rpineau/RTI-Dome/domelist RTI-Dome.txt

//See hardwarelist.txt for details on this file format.
//Version|Manufacturer|Model|Comment|MapsTo|PlugInDllName|X2Developer|Windows|Mac|Linux|
2|RTI-Zone|RTI-Dome|RTI-Dome Arduino DUE Controller| |libRTI-Dome|X2Dome m1OASYS|1|1|1|
