rpineau/RTI-Dome/Hardware/RTI-Dome-Shutter/RTI-Dome-Shutter.brd

## EAGLE design Hardware/RTI-Dome-Shutter/RTI-Dome-Shutter.brd (2022-07-01)

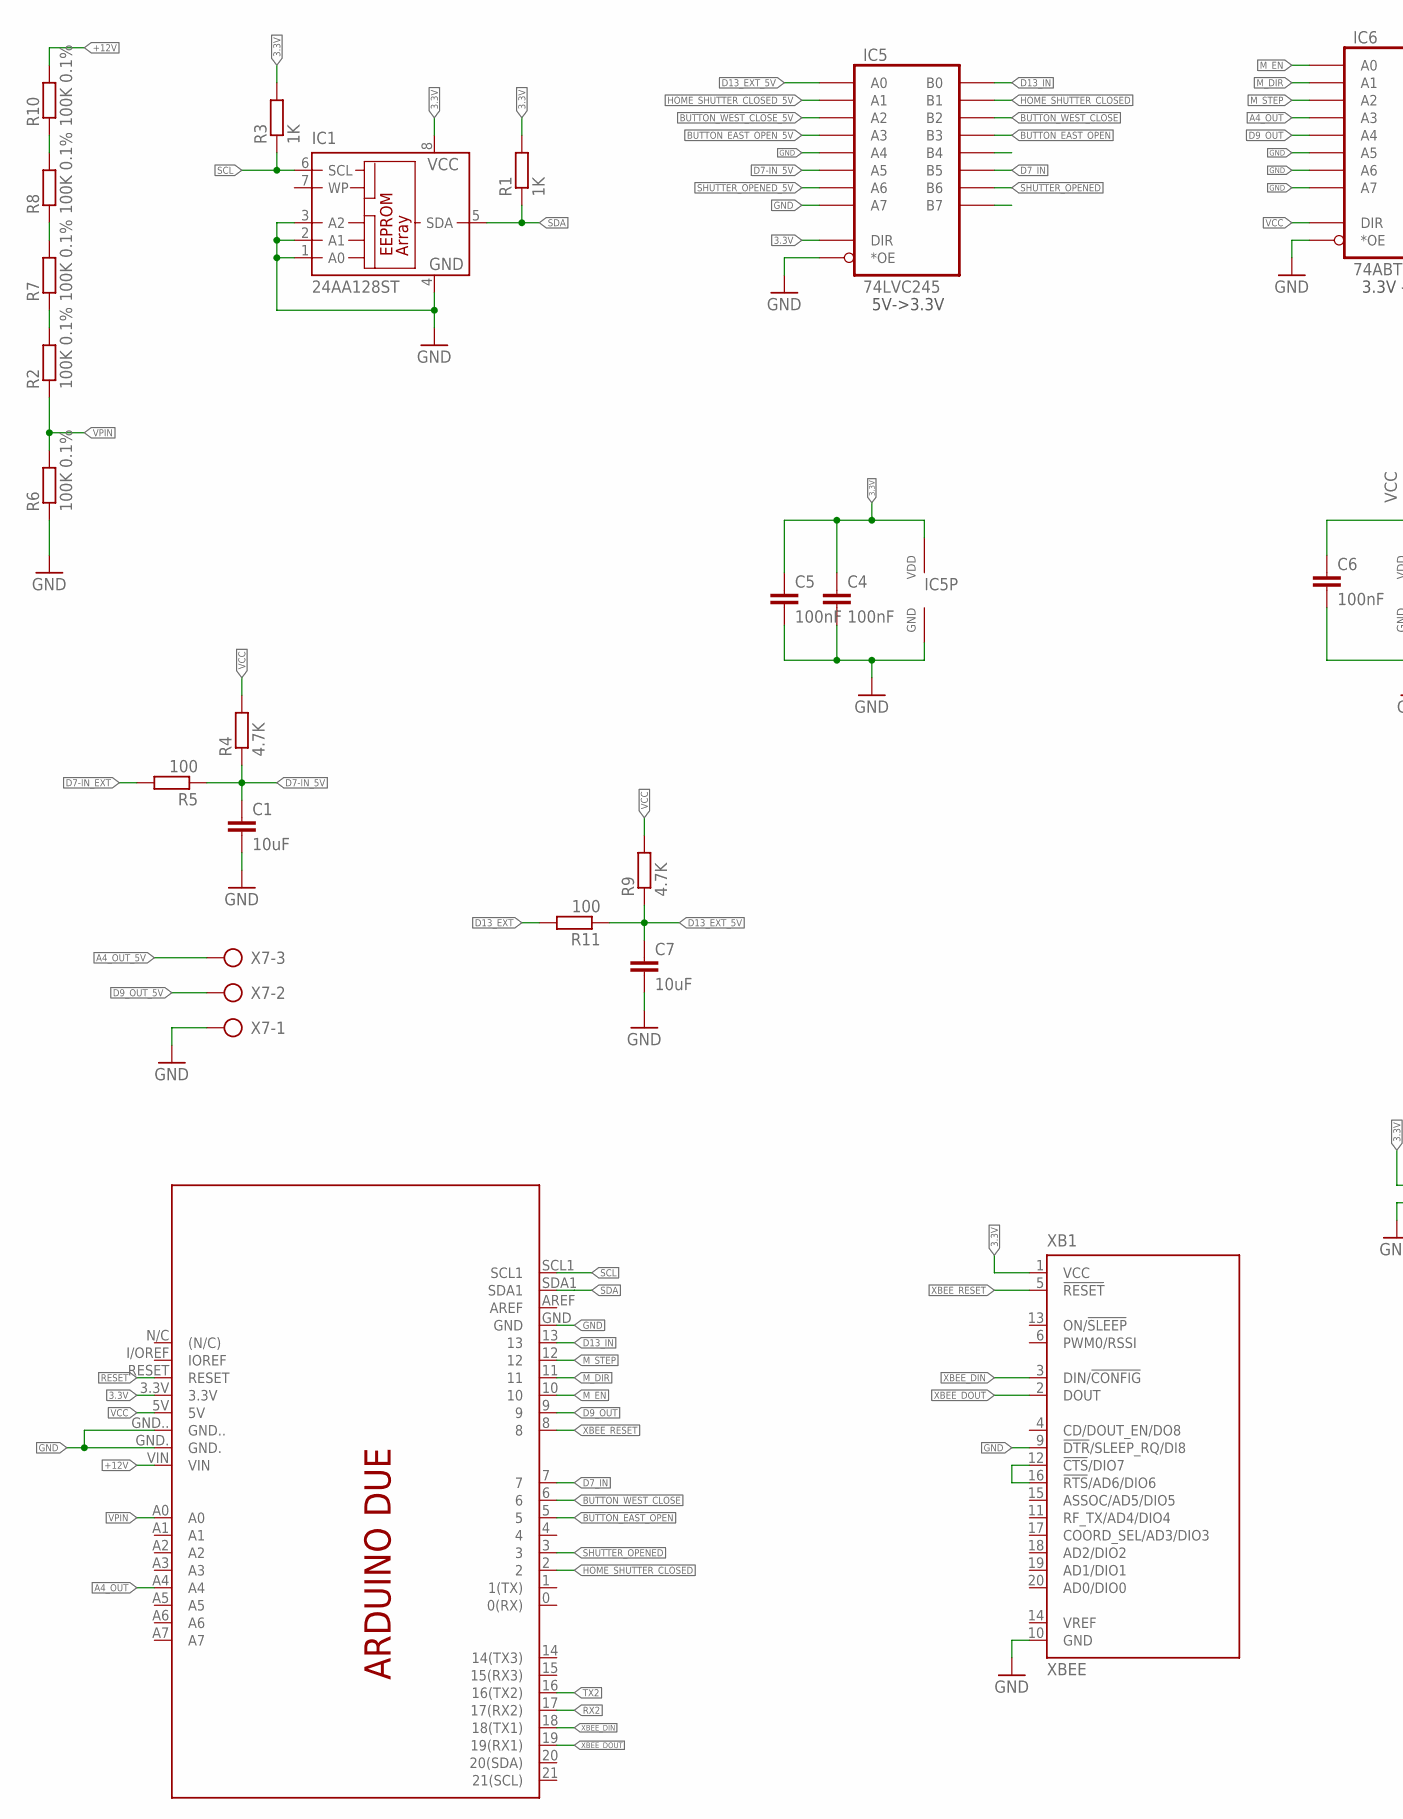
[picture p1: schematic RTI-Dome-Shutter.sch, part in row 1, column 1]

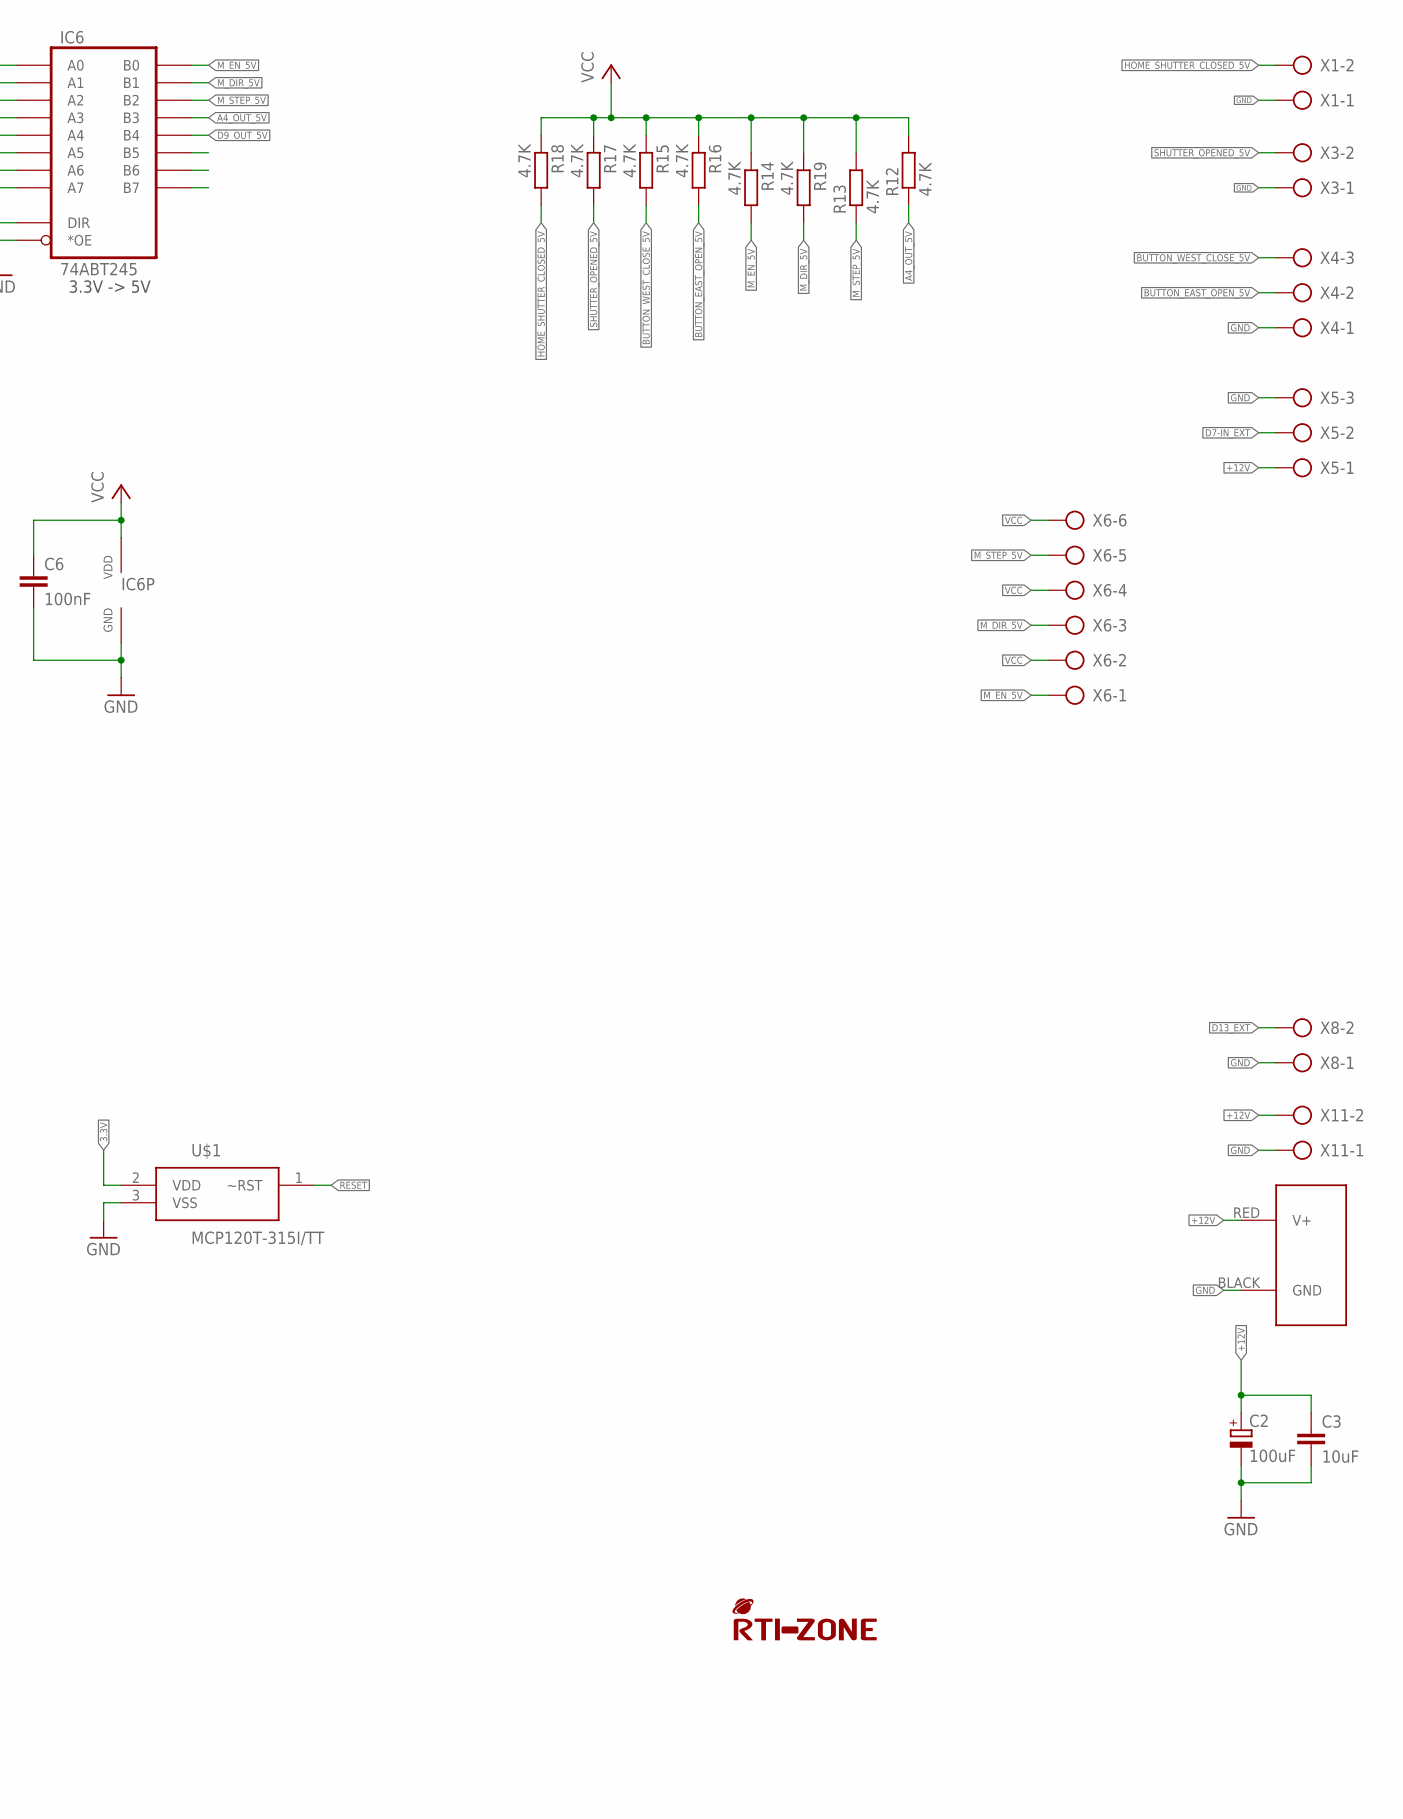
[picture p2: schematic RTI-Dome-Shutter.sch, part in row 1, column 2]

Parts:
C1, C3, C7: 10uF; C0805
C2: 100uF; UD-10X10_NICHICON
C4, C5, C6: 100nF; C0805
IC1: 24AA128ST; TSSOP8
IC5: 74LVC245; TSSOP20
IC6: 74ABT245; TSSOP20
J1: POWERPOLE_POWER45A; POWERPOLE_PAIR_45A
PCB1: ARDUINO_DUE_SHIELD_SHORT
R1, R3: 1K; R0805
R2, R6, R7, R8, R10: 100K 0.1%; R0805
R4, R9, R12, R13, R14, R15, R16, R17, R18, R19: 4.7K; R0805
R5, R11: 100; R0805
U$1: MCP120T-315I/TT; SOT95P237X112-3N; MPN MCP120T-315I/TT
U$4: RTI-LOGO_BIG; LOGO_BIG
X1, X3, X8, X11: AK500/2
X4, X5, X7: AK500/3
X6: AK500/6
XB1: XBEE

Connections:
3.3V: C4.1, C5.1, IC1.8 (VCC), IC5.P$1 (DIR), IC5.P$20 (VDD), PCB1.3.3V, R1.2, R3.2, U$1.2 (VDD), XB1.1 (VCC)
+12V: C2.+, C3.1, J1.RED (V+), PCB1.VIN, R10.2, X5.1, X11.2
A4_OUT: IC6.P$5 (A3), PCB1.A4
A4_OUT_5V: IC6.P$15 (B3), R12.1, X7.3
BUTTON_EAST_OPEN: IC5.P$15 (B3), PCB1.5
BUTTON_EAST_OPEN_5V: IC5.P$5 (A3), R16.2, X4.2
BUTTON_WEST_CLOSE: IC5.P$16 (B2), PCB1.6
BUTTON_WEST_CLOSE_5V: IC5.P$4 (A2), R15.2, X4.3
D7-IN_5V: C1.1, IC5.P$7 (A5), R4.1, R5.1
D7-IN_EXT: R5.2, X5.2
D7_IN: IC5.P$13 (B5), PCB1.7
D9_OUT: IC6.P$6 (A4), PCB1.9
D9_OUT_5V: IC6.P$14 (B4), X7.2
D13_EXT: R11.2, X8.2
D13_EXT_5V: C7.1, IC5.P$2 (A0), R9.1, R11.1
D13_IN: IC5.P$18 (B0), PCB1.13
GND: C1.2, C2.-, C3.2, C4.2, C5.2, C6.2, C7.2, IC1.1 (A0), IC1.2 (A1), IC1.3 (A2), IC1.4 (GND), IC5.P$6 (A4), IC5.P$9 (A7), IC5.P$10 (GND), IC5.P$19 (*OE), IC6.P$7 (A5), IC6.P$8 (A6), IC6.P$9 (A7), IC6.P$10 (GND), IC6.P$19 (*OE), J1.BLACK (GND), PCB1.GND, PCB1.GND., PCB1.GND.., R6.1, U$1.3 (VSS), X1.1, X3.1, X4.1, X5.3, X7.1, X8.1, X11.1, XB1.9 (!DTR!/SLEEP_RQ/DI8), XB1.10 (GND)
HOME_SHUTTER_CLOSED: IC5.P$17 (B1), PCB1.2
HOME_SHUTTER_CLOSED_5V: IC5.P$3 (A1), R18.2, X1.2
M_DIR: IC6.P$3 (A1), PCB1.11
M_DIR_5V: IC6.P$17 (B1), R19.2, X6.3
M_EN: IC6.P$2 (A0), PCB1.10
M_EN_5V: IC6.P$18 (B0), R14.2, X6.1
M_STEP: IC6.P$4 (A2), PCB1.12
M_STEP_5V: IC6.P$16 (B2), R13.1, X6.5
unnamed: R7.2, R8.1
unnamed: R8.2, R10.1
unnamed: R2.2, R7.1
unnamed: XB1.12 (!CTS!/DIO7), XB1.16 (!RTS!/AD6/DIO6)
RESET: PCB1.RESET, U$1.1 (~RST)
RX2: PCB1.17 (17(RX2))
SCL: IC1.6 (SCL), PCB1.SCL1, R3.1
SDA: IC1.5 (SDA), PCB1.SDA1, R1.1
SHUTTER_OPENED: IC5.P$12 (B6), PCB1.3
SHUTTER_OPENED_5V: IC5.P$8 (A6), R17.2, X3.2
TX2: PCB1.16 (16(TX2))
VCC: C6.1, IC6.P$1 (DIR), IC6.P$20 (VDD), PCB1.5V, R4.2, R9.2, R12.2, R13.2, R14.1, R15.1, R16.1, R17.1, R18.1, R19.1, X6.2, X6.4, X6.6
VPIN: PCB1.A0, R2.1, R6.2
XBEE_DIN: PCB1.18 (18(TX1)), XB1.3 (DIN/!CONFIG)
XBEE_DOUT: PCB1.19 (19(RX1)), XB1.2 (DOUT)
XBEE_RESET: PCB1.8, XB1.5 (!RESET)

Notes on the sheet:
5V->3.3V
3.3V -> 5V

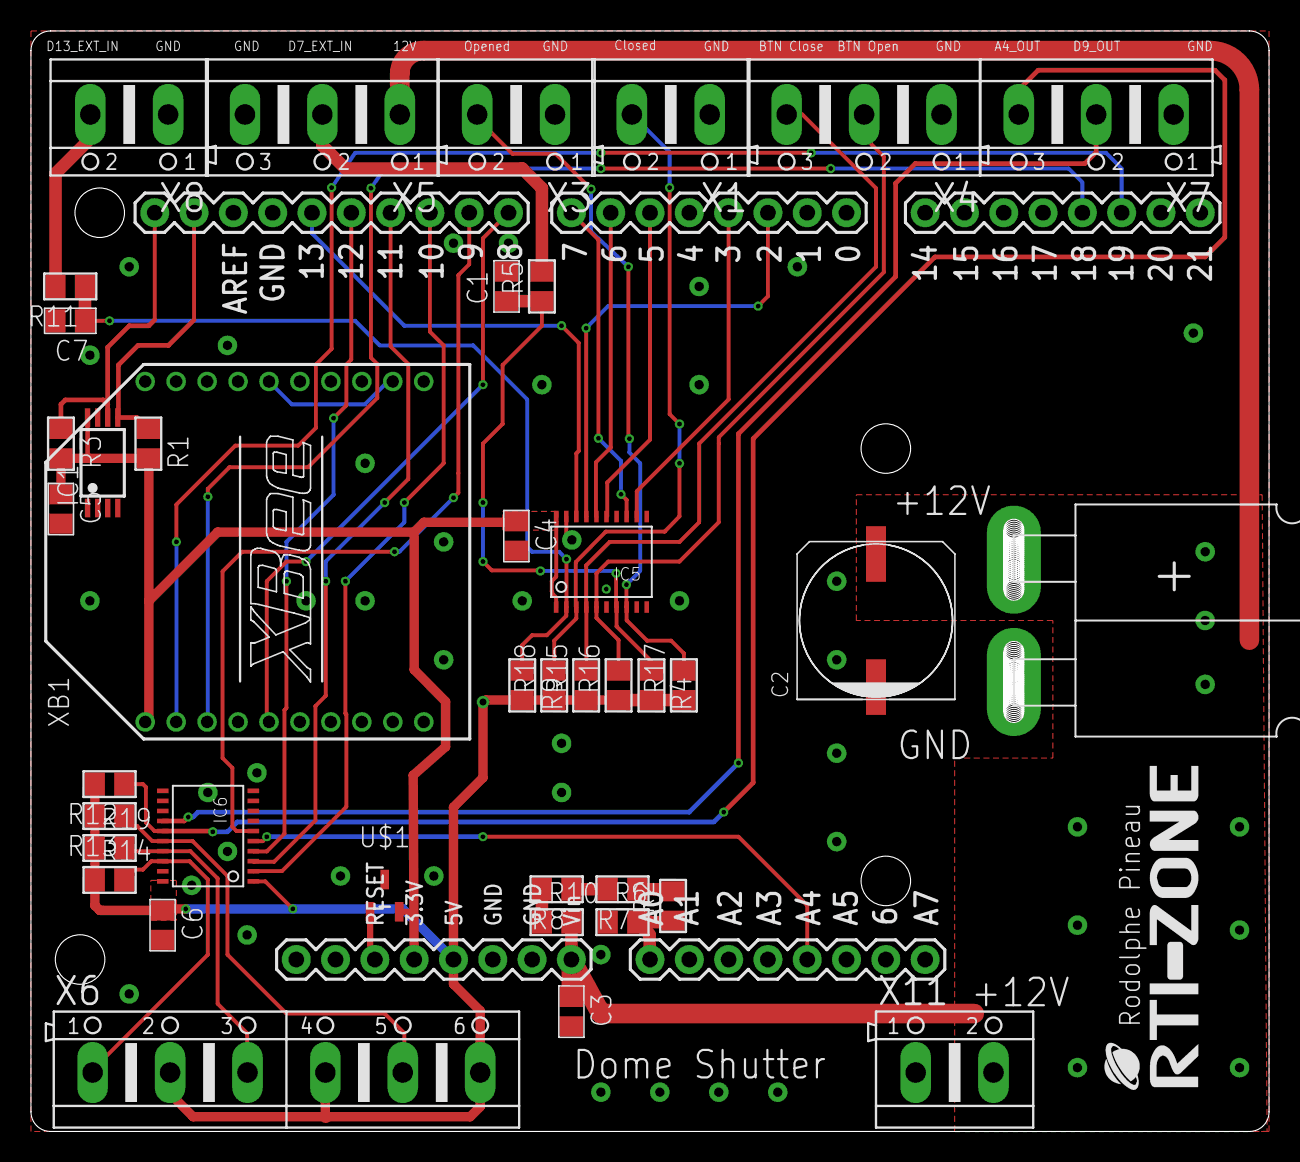
[picture p3: board RTI-Dome-Shutter.brd from above]

Board: 2 copper layers, 80.0 x 71.1 mm, 42 parts (0 on the bottom side), 39 nets.
