rpineau/RTI-Dome/Hardware/12V_switching.brd

## EAGLE design Hardware/12V_switching.brd (2021-03-28)

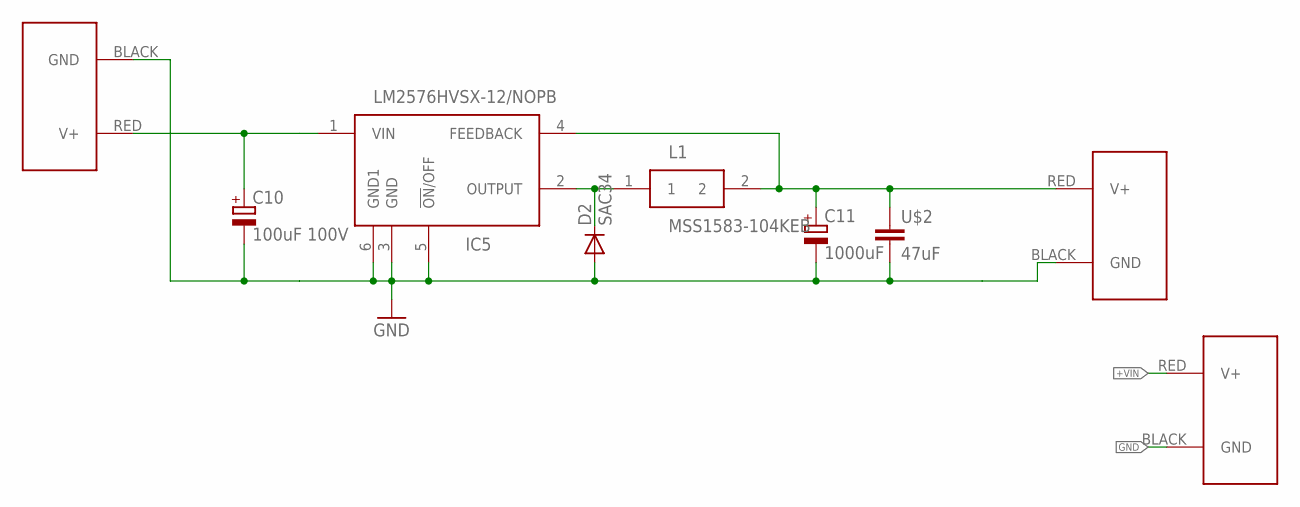
[picture p4: schematic 12V_switching.sch]

Parts:
C10: 100uF 100V; UD-10X10_NICHICON
C11: 1000uF; UD-10X10_NICHICON
D2: SAC34; DO-214AC
IC5: LM2576HVSX-12/NOPB; TO263-5; MOUSER_PART_NUMBER LM2576HVSX-12/NOPB
J1, J2, J3: POWERPOLE_POWER45A; POWERPOLE_PAIR_45A
L1: MSS1583-104KEB; INDPM150150X860N
U$2: 47uF; C1206

Connections:
12VOUT: D2.C, IC5.2 (OUTPUT), L1.1
+12V: C11.+, IC5.4 (FEEDBACK), J2.RED (V+), L1.2, U$2.1
+VIN: C10.+, IC5.1 (VIN), J1.RED (V+)
GND: C10.-, C11.-, D2.A, IC5.3 (GND), IC5.5 (!ON!/OFF), IC5.6 (GND1), J1.BLACK (GND), J2.BLACK (GND), J3.BLACK (GND), U$2.2
V+: J3.RED (V+)

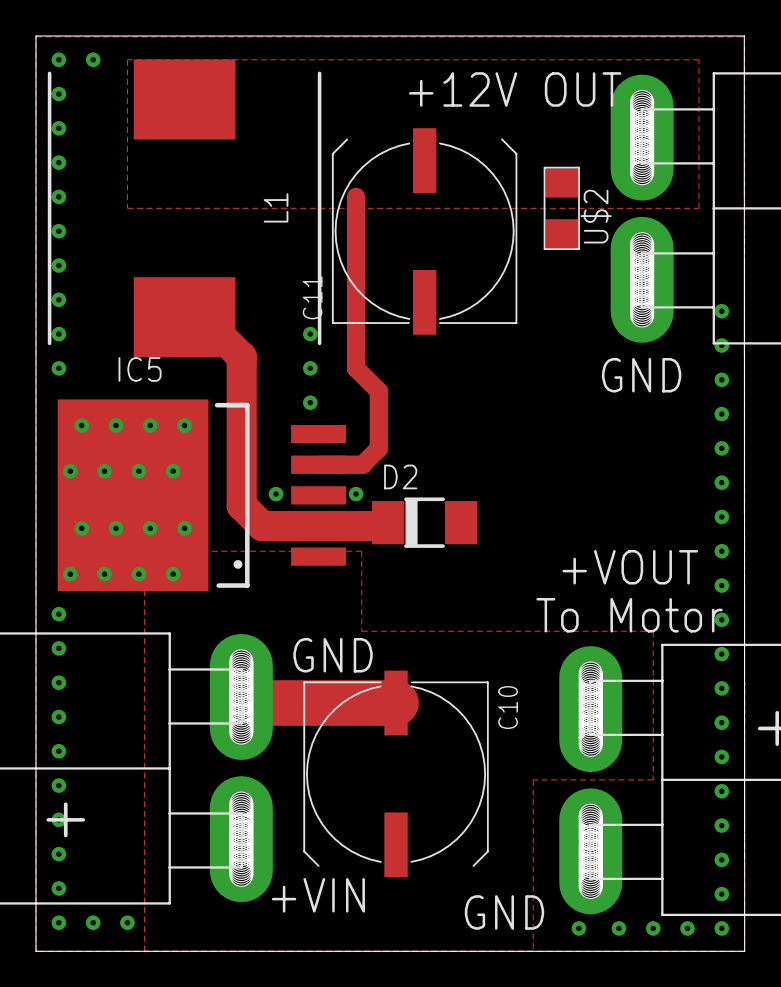
[picture p5: board 12V_switching.brd from above]

Board: 2 copper layers, 39.4 x 50.9 mm, 9 parts (0 on the bottom side), 4 nets.
