rpineau/RTI-Dome/Hardware/RTI-Dome-eth/RTI-Dome-eth.brd

## EAGLE design Hardware/RTI-Dome-eth/RTI-Dome-eth.brd (2022-07-01)

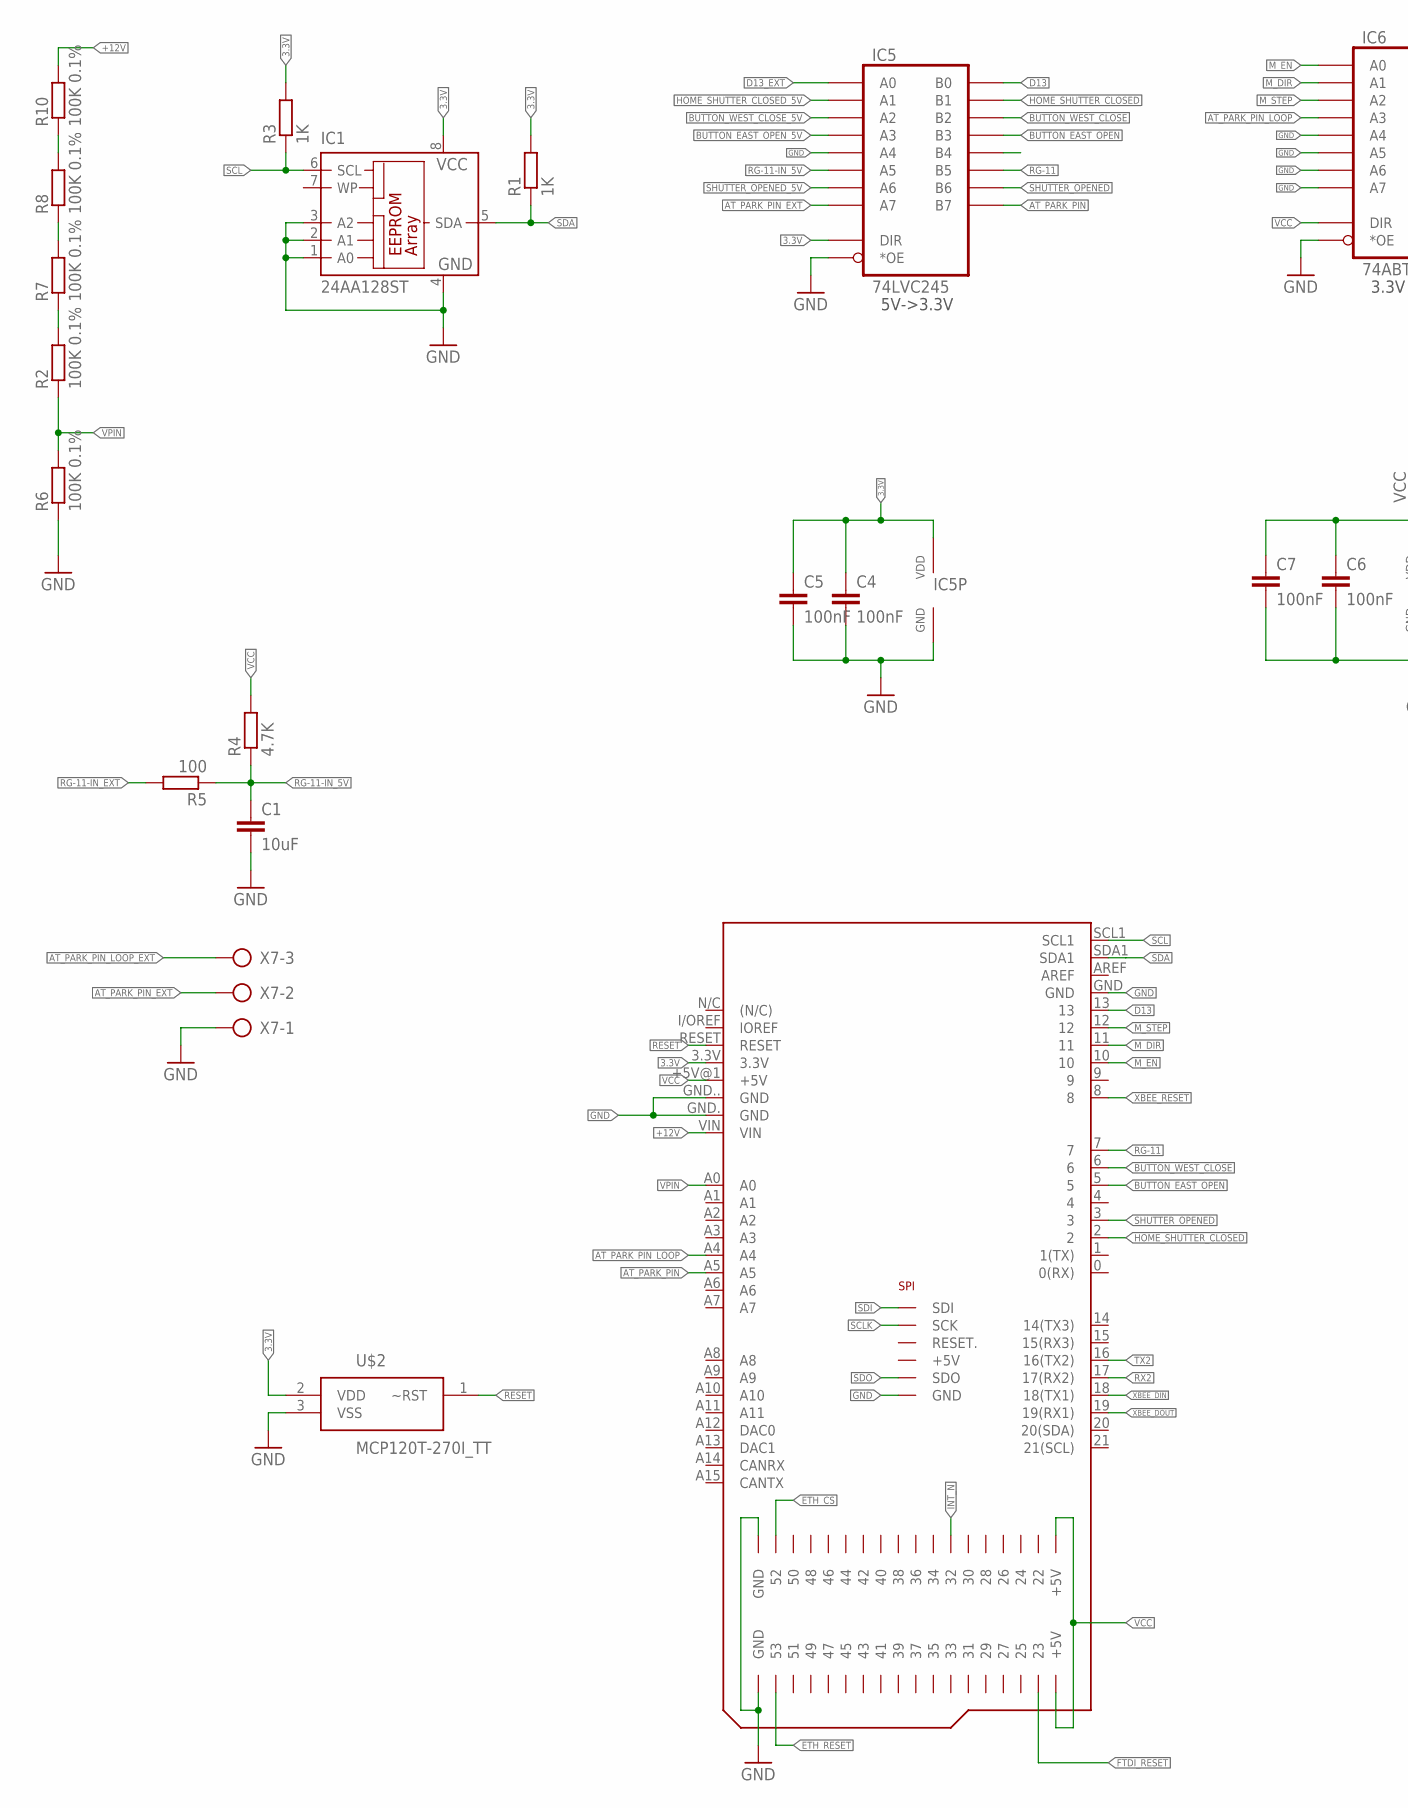
[picture p6: schematic RTI-Dome-eth.sch, sheet 1, part in row 1, column 1]

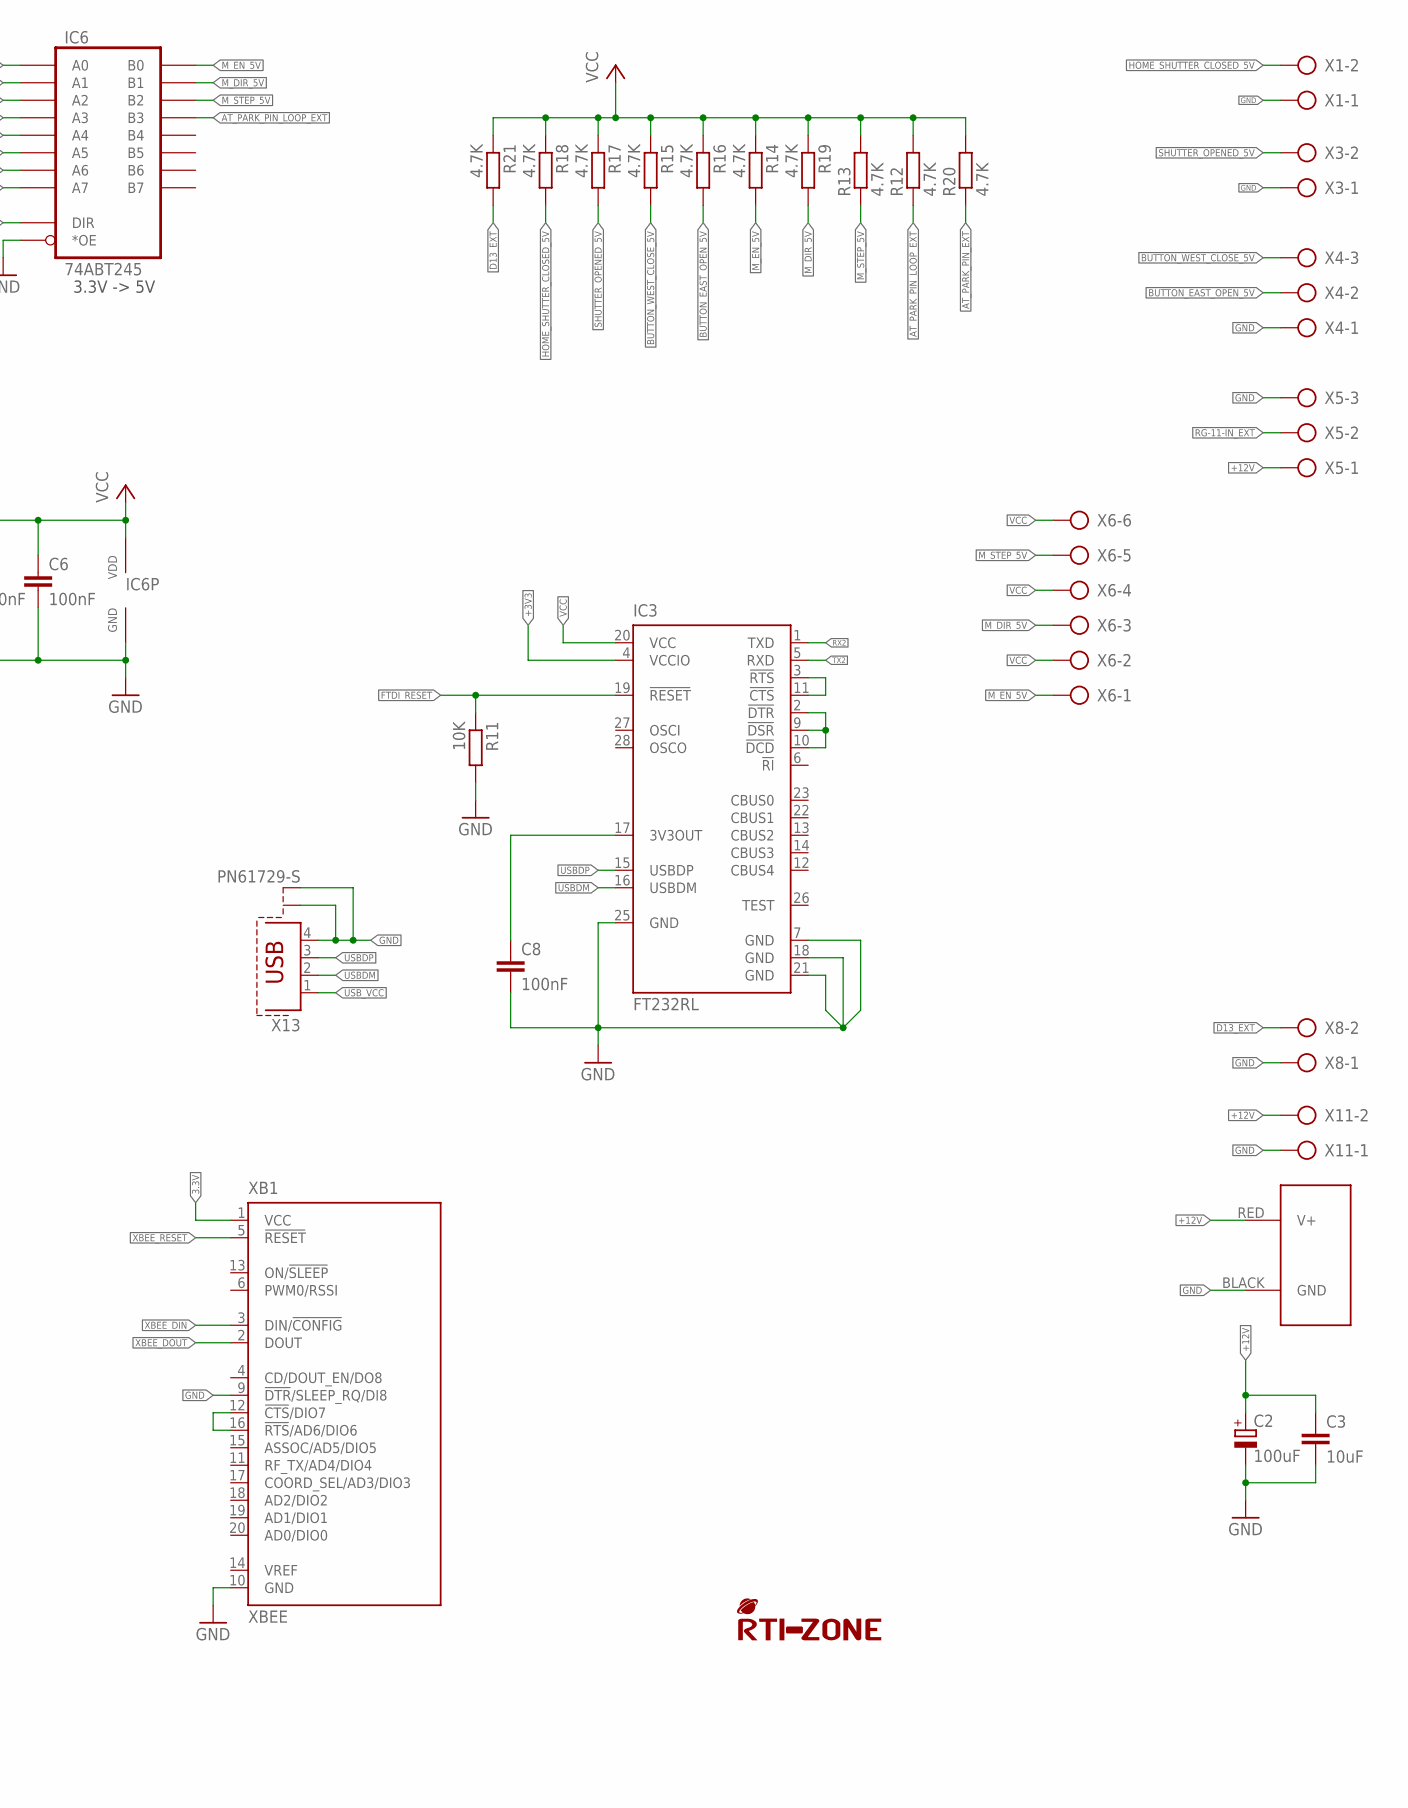
[picture p7: schematic RTI-Dome-eth.sch, sheet 1, part in row 1, column 2]

Parts:
C1, C3: 10uF; C0805; MPN CC0805KKX5R8BB106
C2: 100uF; UD-10X10_NICHICON; MPN MAL215099804E3
C4, C5, C6, C7, C8: 100nF; C0805; MPN 0805YD104KAT2A
IC1: 24AA128ST; TSSOP8
IC3: FT232RL; SSOP28; MPN FT232RL-REEL
IC5: 74LVC245; TSSOP20; MPN 74LVC245APW,112
IC6: 74ABT245; TSSOP20; MPN 74ABT245PW,112
J1: POWERPOLE_POWER45A; POWERPOLE_PAIR_45A
R1, R3: 1K; R0805; MPN RT0805FRE071KL
R2, R6, R7, R8, R10: 100K 0.1%; R0805; MPN AT0805BRD07100KL
R4, R12, R13, R14, R15, R16, R17, R18, R19, R20, R21: 4.7K; R0805; MPN RT0805FRE074K7L
R5: 100; R0805; MPN RT0805FRD07100RL
R11: 10K; R0805; MPN RT0805FRE0710KL
U$1: ARDUINO_DUE_SHIELD_FULL
U$2: MCP120T-270I_TT; SOT95P237X112-3N; MPN MCP120T-270I/TT
U$4: RTI-LOGO_BIG; LOGO_BIG
X1, X3, X8, X11: AK500/2; MPN 691101710002
X4, X5, X7: AK500/3; MPN 691101710003
X6: AK500/6; MPN 30.706
X13: PN61729-S; MPN SS-52300-001
XB1: XBEE

Connections:
3.3V: C4.1, C5.1, IC1.8 (VCC), IC5.P$1 (DIR), IC5.P$20 (VDD), R1.2, R3.2, U$1.3.3V, U$2.2 (VDD), XB1.1 (VCC)
+3V3: IC3.4 (VCCIO); also elsewhere on the board
+5V: U$1.+5V@2 (+5V)
+12V: C2.+, C3.1, J1.RED (V+), R10.2, U$1.VIN, X5.1, X11.2; also elsewhere on the board
AT_PARK_PIN: IC5.P$11 (B7), U$1.A5
AT_PARK_PIN_EXT: IC5.P$9 (A7), R20.1, X7.2
AT_PARK_PIN_LOOP: IC6.P$5 (A3), U$1.A4
AT_PARK_PIN_LOOP_EXT: IC6.P$15 (B3), R12.1, X7.3
BUTTON_EAST_OPEN: IC5.P$15 (B3), U$1.5
BUTTON_EAST_OPEN_5V: IC5.P$5 (A3), R16.2, X4.2
BUTTON_WEST_CLOSE: IC5.P$16 (B2), U$1.6
BUTTON_WEST_CLOSE_5V: IC5.P$4 (A2), R15.2, X4.3
D13: IC5.P$18 (B0), U$1.13
D13_EXT: IC5.P$2 (A0), R21.2, X8.2
DTR_DSR_DCD: IC3.2 (!DTR), IC3.9 (!DSR), IC3.10 (!DCD)
ETH_CS: U$1.52; also elsewhere on the board
ETH_RESET: U$1.53; also elsewhere on the board
FTDI_RESET: IC3.19 (!RESET), R11.1, U$1.23
GND: C1.2, C2.-, C3.2, C4.2, C5.2, C6.2, C7.2, C8.2, IC1.1 (A0), IC1.2 (A1), IC1.3 (A2), IC1.4 (GND), IC3.7 (GND), IC3.18 (GND), IC3.21 (GND), IC3.25 (GND), IC5.P$6 (A4), IC5.P$10 (GND), IC5.P$19 (*OE), IC6.P$6 (A4), IC6.P$7 (A5), IC6.P$8 (A6), IC6.P$9 (A7), IC6.P$10 (GND), IC6.P$19 (*OE), J1.BLACK (GND), R6.1, R11.2, U$1.GND, U$1.GND. (GND), U$1.GND.. (GND), U$1.GND... (GND), U$1.GND.... (GND), U$1.GND__ (GND), U$2.3 (VSS), X1.1, X3.1, X4.1, X5.3, X7.1, X8.1, X11.1, X13.4, X13.S1, X13.S2, XB1.9 (!DTR!/SLEEP_RQ/DI8), XB1.10 (GND); also elsewhere on the board
HOME_SHUTTER_CLOSED: IC5.P$17 (B1), U$1.2
HOME_SHUTTER_CLOSED_5V: IC5.P$3 (A1), R18.2, X1.2
INT_N: U$1.32; also elsewhere on the board
M_DIR: IC6.P$3 (A1), U$1.11
M_DIR_5V: IC6.P$17 (B1), R19.2, X6.3
M_EN: IC6.P$2 (A0), U$1.10
M_EN_5V: IC6.P$18 (B0), R14.2, X6.1
M_STEP: IC6.P$4 (A2), U$1.12
M_STEP_5V: IC6.P$16 (B2), R13.1, X6.5
unnamed: R7.2, R8.1
unnamed: R8.2, R10.1
unnamed: R2.2, R7.1
unnamed: C8.1, IC3.17 (3V3OUT)
unnamed: XB1.12 (!CTS!/DIO7), XB1.16 (!RTS!/AD6/DIO6)
RESET: U$1.RESET, U$2.1 (~RST)
RG-11: IC5.P$13 (B5), U$1.7
RG-11-IN_5V: C1.1, IC5.P$7 (A5), R4.1, R5.1
RG-11-IN_EXT: R5.2, X5.2
RTS_CTS: IC3.3 (!RTS), IC3.11 (!CTS)
RX2: IC3.1 (TXD), U$1.17 (17(RX2))
SCL: IC1.6 (SCL), R3.1, U$1.SCL1
SCLK: U$1.SCK; also elsewhere on the board
SDA: IC1.5 (SDA), R1.1, U$1.SDA1
SDI: U$1.MISO (SDI); also elsewhere on the board
SDO: U$1.MOSI (SDO); also elsewhere on the board
SHUTTER_OPENED: IC5.P$12 (B6), U$1.3
SHUTTER_OPENED_5V: IC5.P$8 (A6), R17.2, X3.2
TX2: IC3.5 (RXD), U$1.16 (16(TX2))
USBDM: IC3.16 (USBDM), X13.2
USBDP: IC3.15 (USBDP), X13.3
USB_VCC: X13.1
VCC: C6.1, C7.1, IC3.20 (VCC), IC6.P$1 (DIR), IC6.P$20 (VDD), R4.2, R12.2, R13.2, R14.1, R15.1, R16.1, R17.1, R18.1, R19.1, R20.2, R21.1, U$1.+5V@1 (+5V), U$1.+5V@3 (+5V), U$1.+5V@4 (+5V), X6.2, X6.4, X6.6
VPIN: R2.1, R6.2, U$1.A0
XBEE_DIN: U$1.18 (18(TX1)), XB1.3 (DIN/!CONFIG)
XBEE_DOUT: U$1.19 (19(RX1)), XB1.2 (DOUT)
XBEE_RESET: U$1.8, XB1.5 (!RESET)

Notes on the sheet:
5V->3.3V
3.3V -> 5V

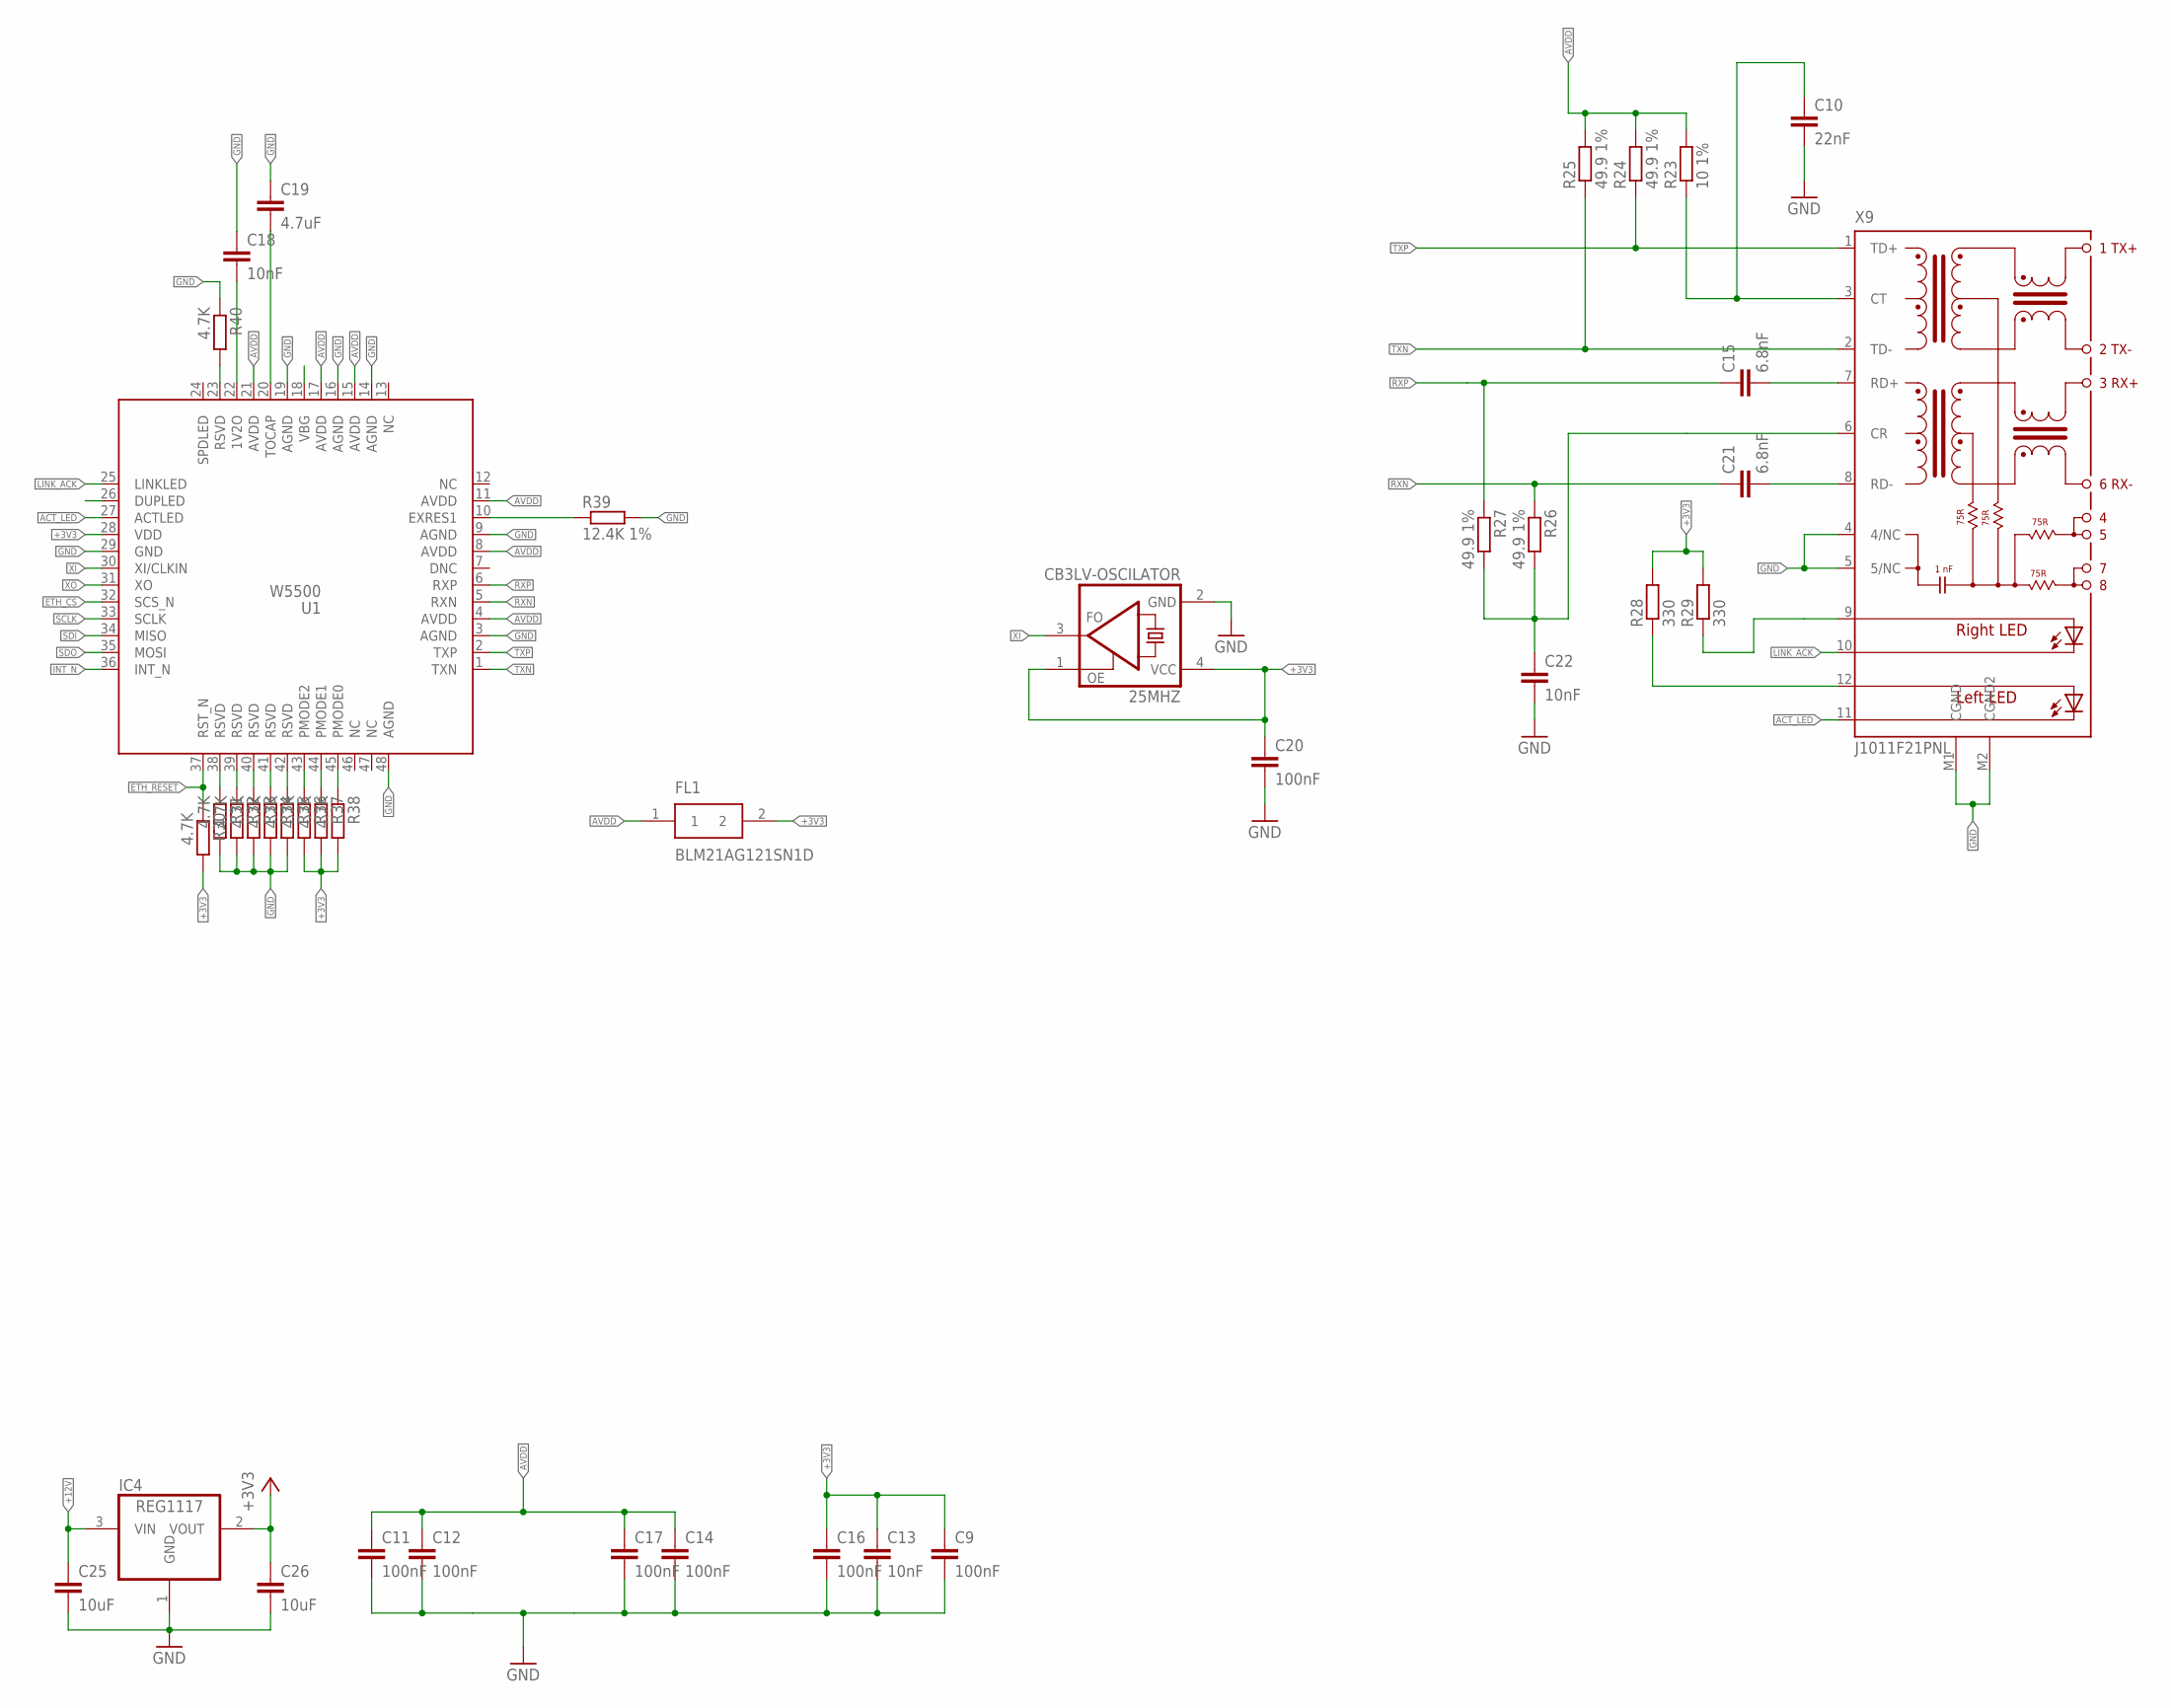
[picture p8: schematic RTI-Dome-eth.sch, sheet 2]

Parts:
25MHZ: CB3LV-OSCILATOR; SMD-7050_4P; MPN CB3LV-3I-25M0000
C9, C11, C12, C14, C16, C17, C20: 100nF; C0805; MPN 0805YD104KAT2A
C10: 22nF; C0805; MPN CC0805JRX7R8BB223
C13, C18, C22: 10nF; C0805; MPN CC0805KRX7R9BB103
C15, C21: 6.8nF; C0805; MPN C0805C682F4HACTU
C19: 4.7uF; C0805; MPN C0805C475J3RACTU
C25, C26: 10uF; C0805; MPN CC0805KKX5R8BB106
FL1: BLM21AG121SN1D; L0805; MPN BLM21AG121SN1D
IC4: REG1117; SOT223; MPN REG1117-3.3/2K5
R23: 10 1%; R0805; MPN RT0805FRE1310RL
R24, R25, R26, R27: 49.9 1%; R0805; MPN RC0805FR-0749R9L
R28, R29: 330; R0805; MPN RC0805JR-07330RL
R30, R31, R32, R33, R34, R35, R36, R37, R38, R40: 4.7K; R0805; MPN RT0805FRE074K7L
R39: 12.4K 1%; R0805; MPN RC0805FR-0712K4L
U1: W5500; LQFP48; MPN W5500
X9: J1011F21PNL; MPN J1011F21PNL

Connections:
+3V3: 25MHZ.1 (OE), 25MHZ.4 (VDD), C9.1, C13.1, C16.1, C20.1, C26.1, FL1.2, IC4.2 (VOUT), R28.2, R29.2, R30.2, R36.2, R37.2, R38.2, U1.28 (VDD); also elsewhere on the board
+12V: C25.1, IC4.3 (VIN); also elsewhere on the board
ACT_LED: U1.27 (ACTLED), X9.11 (C-L)
AVDD: C11.1, C12.1, C14.1, C17.1, FL1.1, R23.2, R24.2, R25.2, U1.4 (AVDD), U1.8 (AVDD), U1.11 (AVDD), U1.15 (AVDD), U1.17 (AVDD), U1.21 (AVDD)
ETH_CS: U1.32 (SCS_N); also elsewhere on the board
ETH_RESET: R30.1, U1.37 (RST_N); also elsewhere on the board
GND: 25MHZ.2 (GND), C9.2, C10.2, C11.2, C12.2, C13.2, C14.2, C16.2, C17.2, C18.1, C19.1, C20.2, C22.2, C25.2, C26.2, IC4.1 (GND), R31.2, R32.2, R33.2, R34.2, R35.2, R39.2, R40.1, U1.3 (AGND), U1.9 (AGND), U1.14 (AGND), U1.16 (AGND), U1.19 (AGND), U1.29 (GND), U1.48 (AGND), X9.4 (4/NC), X9.5 (5/NC), X9.M1 (CGND), X9.M2 (CGND2); also elsewhere on the board
INT_N: U1.36 (INT_N); also elsewhere on the board
LINK_ACK: U1.25 (LINKLED), X9.10 (C-R)
unnamed: C22.1, R26.2, R27.2, X9.6 (CR)
unnamed: R29.1, X9.9 (A-R)
unnamed: R28.1, X9.12 (AL)
unnamed: C15.2, X9.7 (RD+)
unnamed: C21.2, X9.8 (RD-)
unnamed: C10.1, R23.1, X9.3 (CT)
unnamed: R31.1, U1.38 (RSVD)
unnamed: R32.1, U1.39 (RSVD)
unnamed: R33.1, U1.40 (RSVD)
unnamed: R34.1, U1.41 (RSVD)
unnamed: R35.1, U1.42 (RSVD)
unnamed: R36.1, U1.43 (PMODE2)
unnamed: R37.1, U1.44 (PMODE1)
unnamed: R38.1, U1.45 (PMODE0)
unnamed: C19.2, U1.20 (TOCAP)
unnamed: C18.2, U1.22 (1V2O)
unnamed: R39.1, U1.10 (EXRES1)
unnamed: R40.2, U1.23 (RSVD)
RXN: C21.1, R26.1, U1.5 (RXN)
RXP: C15.1, R27.1, U1.6 (RXP)
SCLK: U1.33 (SCLK); also elsewhere on the board
SDI: U1.34 (MISO); also elsewhere on the board
SDO: U1.35 (MOSI); also elsewhere on the board
TXN: R25.1, U1.1 (TXN), X9.2 (TD-)
TXP: R24.1, U1.2 (TXP), X9.1 (TD+)
XI: 25MHZ.3 (FO), U1.30 (XI/CLKIN)
XO: U1.31 (XO)
