rpineau/RTI-Dome/Hardware/RTI-Dome-eth/RTI-Dome-eth.brd

## EAGLE design Hardware/RTI-Dome-eth/RTI-Dome-eth.brd (continued)

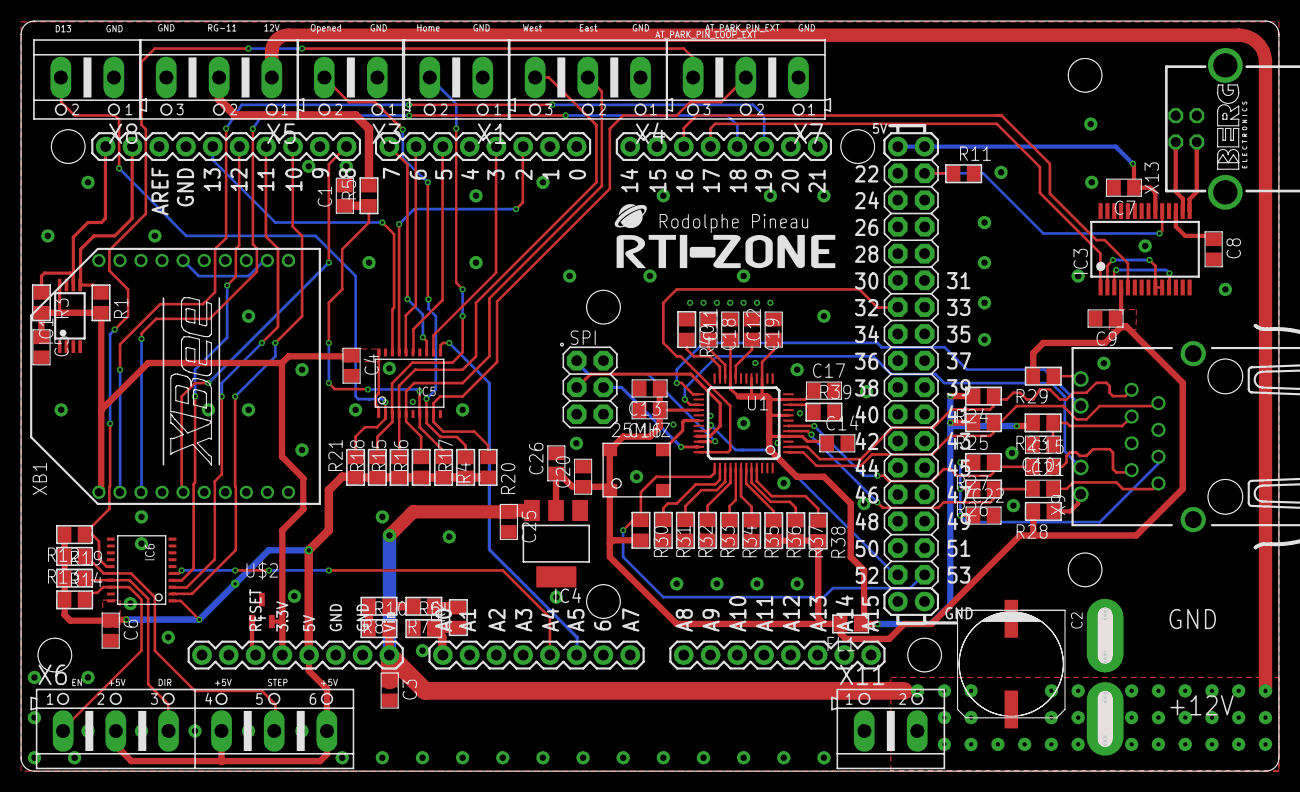
[picture p9: board RTI-Dome-eth.brd from above]

Board: 2 copper layers, 119.4 x 71.2 mm, 85 parts (1 on the bottom side), 79 nets.
