rpineau/RTI-Dome/Hardware/sensors.brd

## EAGLE design Hardware/sensors.brd (2021-03-28)

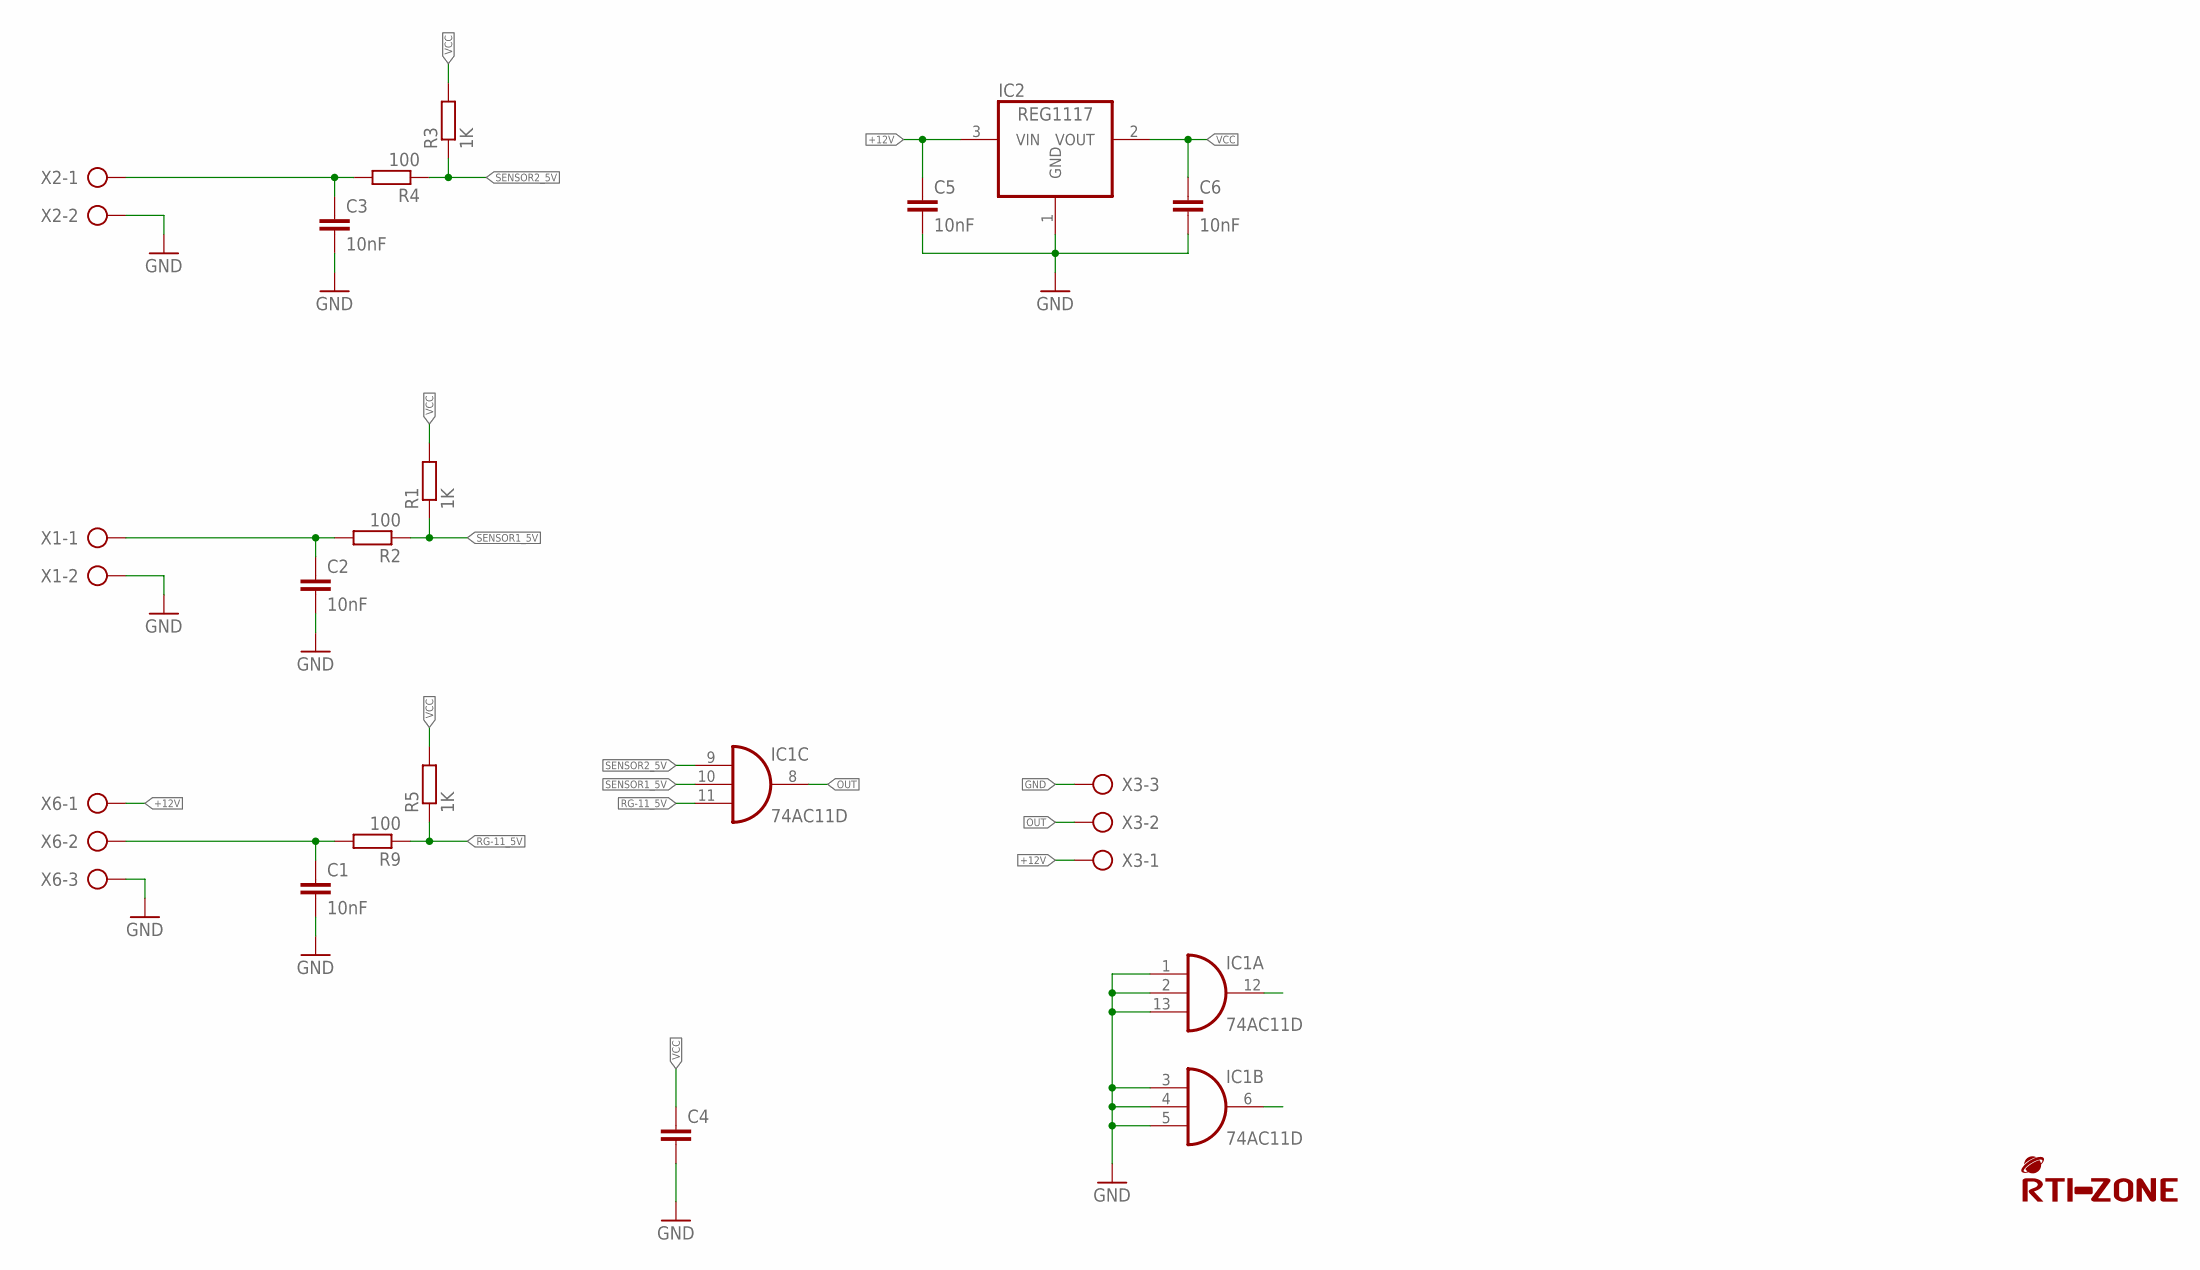
[picture p10: schematic sensors.sch]

Parts:
C1, C2, C3, C5, C6: 10nF; C0805
C4: C-EU'1206'; C1206
IC1: 74AC11D; SO14
IC2: REG1117; SOT223
R1, R3, R5: 1K; R0805
R2, R4, R9: 100; R0805
U$1: RTI-LOGO_BIG; LOGO_BIG
X1, X2: AK500/2
X3, X6: AK500/3

Connections:
+12V: C5.1, IC2.3 (VIN), X3.1, X6.1
GND: C1.2, C2.2, C3.2, C4.2, C5.2, C6.2, IC1.1 (I0), IC1.2 (I1), IC1.3 (I0), IC1.4 (I1), IC1.5 (I2), IC1.7 (GND), IC1.13 (I2), IC2.1 (GND), X1.2, X2.2, X3.3, X6.3
OUT: IC1.8 (O), X3.2
RG-11: C1.1, R9.2, X6.2
RG-11_5V: IC1.11 (I2), R5.1, R9.1
SENSOR1: C2.1, R2.2, X1.1
SENSOR1_5V: IC1.10 (I1), R1.1, R2.1
SENSOR2: C3.1, R4.2, X2.1
SENSOR2_5V: IC1.9 (I0), R3.1, R4.1
VCC: C4.1, C6.1, IC1.14 (VCC), IC2.2 (VOUT), R1.2, R3.2, R5.2

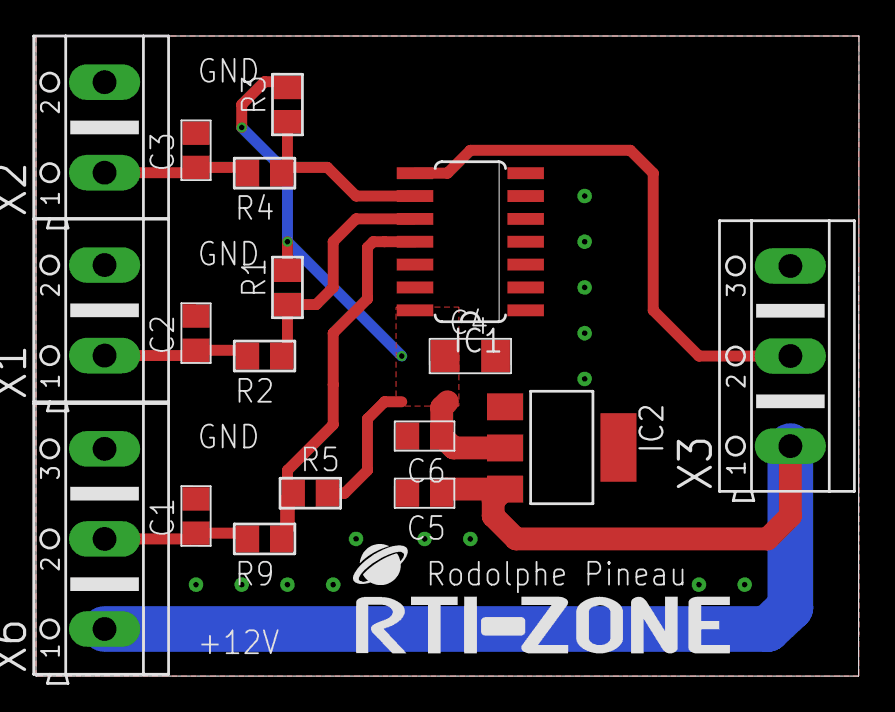
[picture p11: board sensors.brd from above]

Board: 2 copper layers, 45.7 x 35.6 mm, 19 parts (0 on the bottom side), 10 nets.
