rpineau/RTI-Dome/x2dome.cpp

#include "x2dome.h"


X2Dome::X2Dome(const char* pszSelection, const int& nISIndex,
					SerXInterface*						pSerX,
					TheSkyXFacadeForDriversInterface*	pTheSkyX,
					SleeperInterface*					pSleeper,
					BasicIniUtilInterface*			    pIniUtil,
					LoggerInterface*					pLogger,
					MutexInterface*						pIOMutex,
					TickCountInterface*					pTickCount)
{

    m_nPrivateISIndex				= nISIndex;
	m_pSerX							= pSerX;
	m_pTheSkyX			            = pTheSkyX;
	m_pSleeper						= pSleeper;
	m_pIniUtil						= pIniUtil;
	m_pLogger						= pLogger;
	m_pIOMutex						= pIOMutex;
	m_pTickCount					= pTickCount;

	m_bLinked = false;
    m_bCalibratingDome = false;
    m_bSettingPanID = false;
    m_bSettingNetwork = false;
    
    m_bHasShutterControl = false;
    
    m_RTIDome.setSerxPointer(pSerX);

    if (m_pIniUtil)
    {
        m_bLogRainStatus = m_pIniUtil->readInt(PARENT_KEY, CHILD_KEY_LOG_RAIN_STATUS, false);
        m_bHomeOnPark = m_pIniUtil->readInt(PARENT_KEY, CHILD_KEY_HOME_ON_PARK, false);
        m_bHomeOnUnpark = m_pIniUtil->readInt(PARENT_KEY, CHILD_KEY_HOME_ON_UNPARK, false);
        m_RTIDome.setHomeOnPark(m_bHomeOnPark);
        m_RTIDome.setHomeOnUnpark(m_bHomeOnUnpark);
        m_RTIDome.enableRainStatusFile(m_bLogRainStatus);
    }
}


X2Dome::~X2Dome()
{
	if (m_pSerX)
		delete m_pSerX;
	if (m_pTheSkyX)
		delete m_pTheSkyX;
	if (m_pSleeper)
		delete m_pSleeper;
	if (m_pIniUtil)
		delete m_pIniUtil;
	if (m_pLogger)
		delete m_pLogger;
	if (m_pIOMutex)
		delete m_pIOMutex;
	if (m_pTickCount)
		delete m_pTickCount;

}


int X2Dome::establishLink(void)
{
    int nErr;
    char szPort[SERIAL_BUFFER_SIZE];
    X2MutexLocker ml(GetMutex());

    // get serial port device name, and IP and port if the connection is over TCP.
    portNameOnToCharPtr(szPort,SERIAL_BUFFER_SIZE);
    nErr = m_RTIDome.Connect(szPort);
    if(nErr) {
        m_bLinked = false;
    }
    else
        m_bLinked = true;

    if(m_bLinked)
        m_RTIDome.getShutterPresent(m_bHasShutterControl);
	return nErr;
}

int X2Dome::terminateLink(void)
{
    X2MutexLocker ml(GetMutex());

    m_RTIDome.Disconnect();
	m_bLinked = false;

    return SB_OK;
}

 bool X2Dome::isLinked(void) const
{
    return m_bLinked;
}


int X2Dome::queryAbstraction(const char* pszName, void** ppVal)
{
    *ppVal = NULL;

    if (!strcmp(pszName, LoggerInterface_Name))
        *ppVal = GetLogger();
    else if (!strcmp(pszName, ModalSettingsDialogInterface_Name))
        *ppVal = dynamic_cast<ModalSettingsDialogInterface*>(this);
    else if (!strcmp(pszName, X2GUIEventInterface_Name))
        *ppVal = dynamic_cast<X2GUIEventInterface*>(this);
    else if (!strcmp(pszName, SerialPortParams2Interface_Name))
        *ppVal = dynamic_cast<SerialPortParams2Interface*>(this);

    return SB_OK;
}

#pragma mark - UI binding

int X2Dome::execModalSettingsDialog()
{
    int nErr = SB_OK;
    X2ModalUIUtil uiutil(this, GetTheSkyXFacadeForDrivers());
    X2GUIInterface*					ui = uiutil.X2UI();
    X2GUIExchangeInterface*			dx = NULL;//Comes after ui is loaded
    bool bPressedOK = false;
    std::stringstream sTmpBuf;
    std::string fName;
    double dHomeAz = 0;
    double dParkAz = 0;
    double dDomeBattery = 0 , dDomeCutOff = 0;
    double dShutterBattery =0 , dShutterCutOff = 0;
    bool nReverseDir = false;
    int n_nbStepPerRev = 0;
    int nRainSensorStatus = NOT_RAINING;
    int nRSpeed = 0;
    int nRAcc = 0;
    int nSSpeed = 0;
    int nSAcc = 0;
	int nWatchdog = 0;
    int nRainAction = 0;
    double  batRotCutOff = 0;
    double  batShutCutOff = 0;
    std::string sDummy;
    bool bUseDHCP = false;
    std::string sIpAddress;
    std::string sSubnetMask;
    std::string sGatewayIP;
    
    if (NULL == ui)
        return ERR_POINTER;

    if ((nErr = ui->loadUserInterface("RTI-Dome.ui", deviceType(), m_nPrivateISIndex)))
        return nErr;

    if (NULL == (dx = uiutil.X2DX()))
        return ERR_POINTER;

    X2MutexLocker ml(GetMutex());
    m_RTIDome.getShutterPresent(m_bHasShutterControl);

    // set controls state depending on the connection state
    if(m_bHomeOnPark) {
        dx->setChecked("homeOnPark",true);
    }
    else {
        dx->setChecked("homeOnPark",false);
    }

    if(m_bHomeOnUnpark) {
        dx->setChecked("homeOnUnpark",true);
    }
    else {
        dx->setChecked("homeOnUnpark",false);
    }
    // disbale these for now, these will be for the number of shuter and sequence for openging/closing
    dx->setEnabled("checkBox_3",false);
    dx->setEnabled("comboBox_2",false);
    
    
    if(m_bLogRainStatus) {
        dx->setChecked("checkBox",true);
        m_RTIDome.getRainStatusFileName(fName);
        dx->setPropertyString("filePath","text", fName.c_str());
    }
    else {
        dx->setChecked("checkBox",false);
        dx->setPropertyString("filePath","text", "");
    }

    if(m_bLinked) {
        if(m_bHasShutterControl)
            m_RTIDome.sendShutterHello();   // refresh values.
        dx->setEnabled("homePosition",true);
        dx->setEnabled("parkPosition",true);
        dx->setEnabled("needReverse",true);
        nErr = m_RTIDome.getDefaultDir(nReverseDir);
        if(nReverseDir)
            dx->setChecked("needReverse",false);
        else
            dx->setChecked("needReverse",true);

        // read values from dome controller
        dx->setEnabled("ticksPerRev",true);
        n_nbStepPerRev = m_RTIDome.getNbTicksPerRev();
        dx->setPropertyInt("ticksPerRev","value", n_nbStepPerRev);

        dx->setEnabled("rotationSpeed",true);
        m_RTIDome.getRotationSpeed(nRSpeed);
        dx->setPropertyInt("rotationSpeed","value", nRSpeed);

        dx->setEnabled("rotationAcceletation",true);
        m_RTIDome.getRotationAcceleration(nRAcc);
        dx->setPropertyInt("rotationAcceletation","value", nRAcc);

        dx->setEnabled("pushButton_3", true);

        if(m_bHasShutterControl) {
            dx->setEnabled("shutterSpeed",true);
            nErr = m_RTIDome.getShutterSpeed(nSSpeed);
            dx->setPropertyInt("shutterSpeed","value", nSSpeed);

            dx->setEnabled("shutterAcceleration",true);
            m_RTIDome.getShutterAcceleration(nSAcc);
            dx->setPropertyInt("shutterAcceleration","value", nSAcc);

            dx->setEnabled("pushButton_4", true);

            dx->setEnabled("shutterWatchdog",true);
            m_RTIDome.getSutterWatchdogTimerValue(nWatchdog);
            dx->setPropertyInt("shutterWatchdog", "value", nWatchdog);

            dx->setEnabled("lowShutBatCutOff",true);
            dx->setText("shutterPresent", "<html><head/><body><p><span style=\" color:#00FF00;\">Shutter present</span></p></body></html>");
        } else {
            dx->setEnabled("shutterSpeed",false);
            dx->setPropertyInt("shutterSpeed","value",0);
            dx->setEnabled("shutterAcceleration",false);
            dx->setPropertyInt("shutterAcceleration","value",0);
            dx->setEnabled("shutterWatchdog",false);
            dx->setPropertyInt("shutterWatchdog","value",0);
            dx->setEnabled("pushButton_4", false);
            dx->setPropertyInt("shutterWatchdog", "value", 0);
            dx->setEnabled("lowShutBatCutOff",false);
            dx->setText("shutterPresent", "<html><head/><body><p><span style=\" color:#FF0000;\">No Shutter detected</span></p></body></html>");
        }

        // panID
        dx->setEnabled("panID", true);
        dx->setEnabled("pushButton_2", true);
        nErr = m_RTIDome.getPanId(m_nPanId);
        if(nErr)
            m_nPanId = 0;
        dx->setPropertyInt("panID", "value", m_nPanId);

        m_RTIDome.getBatteryLevels(dDomeBattery, dDomeCutOff, dShutterBattery, dShutterCutOff);
        dx->setPropertyDouble("lowRotBatCutOff","value", dDomeCutOff);
        sTmpBuf << std::fixed << std::setprecision(2) << dDomeBattery << " V";
        dx->setPropertyString("domeBatteryLevel","text", sTmpBuf.str().c_str());

        if(m_bHasShutterControl) {
            dx->setPropertyDouble("lowShutBatCutOff","value", dShutterCutOff);
            std::stringstream().swap(sTmpBuf);
            if(dShutterBattery>=0.0f)
                sTmpBuf << std::fixed << std::setprecision(2) << dShutterBattery << " V";
            else
                sTmpBuf << "--";
            dx->setPropertyString("shutterBatteryLevel","text", sTmpBuf.str().c_str());
        }
        else {
            dx->setPropertyDouble("lowShutBatCutOff","value", 0);
            dx->setPropertyString("shutterBatteryLevel","text", "--");
        }

        m_RTIDome.getRainAction(nRainAction);
        dx->setCurrentIndex("comboBox", nRainAction);
        
        nErr = m_RTIDome.getRainSensorStatus(nRainSensorStatus);
        if(nErr)
            dx->setPropertyString("rainStatus","text", "--");
        else {
            std::stringstream().swap(sTmpBuf);
            sTmpBuf << (nRainSensorStatus==NOT_RAINING ? "<html><head/><body><p><span style=\" color:#00FF00;\">Not raining</span></p></body></html>" : "<html><head/><body><p><span style=\" color:#FF0000;\">Raining</span></p></body></html>");
            dx->setPropertyString("rainStatus","text", sTmpBuf.str().c_str());
        }

        nErr = m_RTIDome.getMACAddress(sDummy);
        if(nErr)
            sDummy = "";
        dx->setPropertyString("MACAddress", "text", sDummy.c_str());

        nErr = m_RTIDome.getUseDHCP(bUseDHCP);
        dx->setChecked("checkBox_2", bUseDHCP);
        if(bUseDHCP) {
            dx->setEnabled("IPAddress", false);
            dx->setEnabled("SubnetMask", false);
            dx->setEnabled("GatewayIP", false);
        }
        else { // not using dhcp so the field are editable
            dx->setEnabled("IPAddress", true);
            dx->setEnabled("SubnetMask", true);
            dx->setEnabled("GatewayIP", true);
        }

        nErr = m_RTIDome.getIpAddress(sIpAddress);
        if(nErr)
            sIpAddress = "";
        dx->setPropertyString("IPAddress", "text", sIpAddress.c_str());

        nErr = m_RTIDome.getSubnetMask(sSubnetMask);
        if(nErr)
            sSubnetMask = "";
        dx->setPropertyString("SubnetMask", "text", sSubnetMask.c_str());

        nErr = m_RTIDome.getIPGateway(sGatewayIP);
        if(nErr)
            sGatewayIP = "";
        dx->setPropertyString("GatewayIP", "text", sGatewayIP.c_str());
        
        dx->setEnabled("pushButton",true);
    }
    else {
        dx->setEnabled("homePosition", false);
        dx->setEnabled("parkPosition", false);
        dx->setEnabled("needReverse", false);
        dx->setEnabled("ticksPerRev", false);
        dx->setEnabled("rotationSpeed", false);
        dx->setEnabled("rotationAcceletation", false);
        dx->setEnabled("shutterSpeed", false);
        dx->setEnabled("shutterAcceleration", false);
		dx->setEnabled("shutterWatchdog", false);
        dx->setEnabled("lowRotBatCutOff", false);
        dx->setEnabled("lowShutBatCutOff", false);
        dx->setEnabled("comboBox", false);
        dx->setPropertyString("domeBatteryLevel", "text", "--");
        dx->setPropertyString("shutterBatteryLevel", "text", "--");
        dx->setEnabled("panID", false);
        dx->setPropertyInt("panID", "value", 0);
        dx->setEnabled("pushButton_2", false);
        dx->setEnabled("pushButton", false);
        dx->setEnabled("pushButton_3", false);
        dx->setEnabled("pushButton_4", false);
        dx->setPropertyString("domePointingError", "text", "--");
        dx->setPropertyString("rainStatus","text", "--");
    
        dx->setEnabled("checkBox_2", false);
        dx->setPropertyString("MACAddress", "text", "");
        dx->setEnabled("IPAddress", false);
        dx->setPropertyString("IPAddress", "text", "");
        dx->setEnabled("SubnetMask", false);
        dx->setPropertyString("SubnetMask", "text", "");
        dx->setEnabled("GatewayIP", false);
        dx->setPropertyString("GatewayIP", "text", "");
        dx->setEnabled("pushButton_5", false);
    }
    dx->setPropertyDouble("homePosition","value", m_RTIDome.getHomeAz());
    dx->setPropertyDouble("parkPosition","value", m_RTIDome.getParkAz());

    //Display the user interface
    if ((nErr = ui->exec(bPressedOK)))
        return nErr;

    //Retreive values from the user interface
    if (bPressedOK) {
        dx->propertyInt("ticksPerRev", "value", n_nbStepPerRev);
        dx->propertyDouble("homePosition", "value", dHomeAz);
        dx->propertyDouble("parkPosition", "value", dParkAz);
        dx->propertyInt("rotationSpeed", "value", nRSpeed);
        dx->propertyInt("rotationAcceletation", "value", nRAcc);
        dx->propertyInt("shutterSpeed", "value", nSSpeed);
        dx->propertyInt("shutterAcceleration", "value", nSAcc);
		dx->propertyInt("shutterWatchdog", "value", nWatchdog);
        dx->propertyDouble("lowRotBatCutOff", "value", batRotCutOff);
        dx->propertyDouble("lowShutBatCutOff", "value", batShutCutOff);
        nRainAction = dx->currentIndex("comboBox");
        m_bHomeOnPark = dx->isChecked("homeOnPark");
        m_RTIDome.setHomeOnPark(m_bHomeOnPark);
        m_bHomeOnUnpark = dx->isChecked("homeOnUnpark");
        m_RTIDome.setHomeOnUnpark(m_bHomeOnUnpark);
        nReverseDir = dx->isChecked("needReverse");
        m_bLogRainStatus = dx->isChecked("checkBox");
        m_RTIDome.enableRainStatusFile(m_bLogRainStatus);

        if(m_bLinked) {
            m_RTIDome.setDefaultDir(!nReverseDir);
            m_RTIDome.setHomeAz(dHomeAz);
            m_RTIDome.setParkAz(dParkAz);
            m_RTIDome.setNbTicksPerRev(n_nbStepPerRev);
            m_RTIDome.setRotationSpeed(nRSpeed);
            m_RTIDome.setRotationAcceleration(nRAcc);
			m_RTIDome.setBatteryCutOff(batRotCutOff, batShutCutOff);
            m_RTIDome.setRainAction(nRainAction);
			if(m_bHasShutterControl) {
				m_RTIDome.setShutterSpeed(nSSpeed);
				m_RTIDome.setShutterAcceleration(nSAcc);
				m_RTIDome.setSutterWatchdogTimerValue(nWatchdog);
				m_RTIDome.sendShutterHello();
			}
        }

        // save the values to persistent storage
        nErr |= m_pIniUtil->writeInt(PARENT_KEY, CHILD_KEY_HOME_ON_PARK, m_bHomeOnPark);
        nErr |= m_pIniUtil->writeInt(PARENT_KEY, CHILD_KEY_HOME_ON_UNPARK, m_bHomeOnUnpark);
        nErr |= m_pIniUtil->writeInt(PARENT_KEY, CHILD_KEY_LOG_RAIN_STATUS, m_bLogRainStatus);
    }
    return nErr;

}

void X2Dome::uiEvent(X2GUIExchangeInterface* uiex, const char* pszEvent)
{
    bool bComplete = false;
    int nErr;
    double dDomeBattery, dDomeCutOff;
    double dShutterBattery, dShutterCutOff;
    char szTmpBuf[SERIAL_BUFFER_SIZE];
    std::stringstream sTmpBuf;
    std::stringstream sErrorMessage;
    std::string fName;
    std::string sDummy;
    int nRainSensorStatus = NOT_RAINING;
    bool bShutterPresent;
    int nPanId;
    int nSpeed;
    int nAcc;
    int n_nbStepPerRev;
    int nWatchdog;
    bool bUseDHCP;
    
    if (!strcmp(pszEvent, "on_pushButtonCancel_clicked") && m_bCalibratingDome)
        m_RTIDome.abortCurrentCommand();

    if (!strcmp(pszEvent, "on_timer"))
    {
        m_RTIDome.getShutterPresent(bShutterPresent);
        if(bShutterPresent != m_bHasShutterControl) {
            m_bHasShutterControl = bShutterPresent;
            if(m_bHasShutterControl && m_bLinked) {
                uiex->setText("shutterPresent", "<html><head/><body><p><span style=\" color:#00FF00;\">Shutter present</span></p></body></html>");
                uiex->setEnabled("shutterSpeed",true);
                m_RTIDome.getShutterSpeed(nSpeed);
                uiex->setPropertyInt("shutterSpeed","value", nSpeed);

                uiex->setEnabled("shutterAcceleration",true);
                m_RTIDome.getShutterAcceleration(nAcc);
                uiex->setPropertyInt("shutterAcceleration","value", nAcc);

                uiex->setEnabled("shutterWatchdog",true);
                m_RTIDome.getSutterWatchdogTimerValue(nWatchdog);
                uiex->setPropertyInt("shutterWatchdog", "value", nWatchdog);
            }
            else {
                uiex->setText("shutterPresent", "<html><head/><body><p><span style=\" color:#FF0000;\">No Shutter detected</span></p></body></html>");
                uiex->setPropertyInt("shutterSpeed","value", 0);
                uiex->setPropertyInt("shutterAcceleration","value", 0);
                uiex->setPropertyInt("shutterWatchdog", "value", 0);
                uiex->setEnabled("shutterSpeed",false);
                uiex->setEnabled("shutterAcceleration",false);
                uiex->setEnabled("shutterWatchdog",false);
                uiex->setPropertyString("shutterBatteryLevel","text", "--");

            }

        }
        if(m_bLinked) {
           if(m_bCalibratingDome) {
                // are we still calibrating ?
                bComplete = false;
                nErr = m_RTIDome.isCalibratingComplete(bComplete);
                if(nErr) {
                    uiex->setEnabled("pushButtonOK",true);
					uiex->setEnabled("pushButtonCancel", true);
                    sErrorMessage << "Error calibrating dome : Error "<< nErr;
                    uiex->messageBox("RTI-Dome Calibrate", sErrorMessage.str().c_str());
                    m_bCalibratingDome = false;
                    return;
                }

                if(!bComplete) {
                    return;
                }

                // enable buttons
                uiex->setEnabled("pushButtonOK",true);
				uiex->setEnabled("pushButtonCancel", true);
				m_bCalibratingDome = false;
				uiex->setText("pushButton", "Calibrate");
                uiex->setEnabled("pushButton_2", true);
                // read step per rev from controller
                uiex->setPropertyInt("ticksPerRev","value", m_RTIDome.getNbTicksPerRev());
			}

            if(m_bSettingPanID) {
                nErr = m_RTIDome.isPanIdSet(m_nPanId, bComplete);
                if(bComplete) {
                    uiex->setEnabled("pushButton_2", true);
                    m_bSettingPanID = false;
                    m_RTIDome.getShutterSpeed(nSpeed);
                    uiex->setPropertyInt("shutterSpeed","value", nSpeed);
                    m_RTIDome.getShutterAcceleration(nAcc);
                    uiex->setPropertyInt("shutterAcceleration","value", nAcc);
                    m_RTIDome.getBatteryLevels(dDomeBattery, dDomeCutOff, dShutterBattery, dShutterCutOff);
                    if(dShutterCutOff < 1.0f) // not right.. ask again
                        m_RTIDome.getBatteryLevels(dDomeBattery, dDomeCutOff, dShutterBattery, dShutterCutOff);
                    sTmpBuf << std::fixed << std::setprecision(2) << dShutterBattery << " V";
                    uiex->setPropertyString("shutterBatteryLevel","text", sTmpBuf.str().c_str());
                    uiex->setEnabled("lowShutBatCutOff",true);
                    uiex->setPropertyDouble("lowShutBatCutOff","value", dShutterCutOff);

                } else {
                    if(m_SetPanIdTimer.GetElapsedSeconds()>PANID_TIMEOUT ) {// 15 seconds is way more than needed.. something when wrong
                        sErrorMessage << "Timeout setting Xbee PAN ID";
                        uiex->messageBox("RTI-Dome Set PanID", sErrorMessage.str().c_str());
                        uiex->setEnabled("pushButton_2", true);
                        m_bSettingPanID = false;
                        m_RTIDome.getPanId(m_nPanId);
                        uiex->setPropertyInt("panID", "value", m_nPanId);
                        return;
                    }
                }
            }

            else if(m_bSettingNetwork) {
                if(m_SetNetworkTimer.GetElapsedSeconds()>5) {
                    nErr = m_RTIDome.getUseDHCP(bUseDHCP);
                    if(bUseDHCP) {
                        uiex->setEnabled("IPAddress", false);
                        uiex->setEnabled("SubnetMask", false);
                        uiex->setEnabled("GatewayIP", false);
                    }
                    else { // not using dhcp so the field are editable
                        uiex->setEnabled("IPAddress", true);
                        uiex->setEnabled("SubnetMask", true);
                        uiex->setEnabled("GatewayIP", true);
                    }
                    m_RTIDome.getIpAddress(sDummy);
                    uiex->setPropertyString("IPAddress", "text", sDummy.c_str());
                    m_RTIDome.getSubnetMask(sDummy);
                    uiex->setPropertyString("SubnetMask", "text", sDummy.c_str());
                    m_RTIDome.getIPGateway(sDummy);
                    uiex->setPropertyString("GatewayIP", "text", sDummy.c_str());
                }
            }

            else if(m_bHasShutterControl && !m_bCalibratingDome) {
                m_RTIDome.getBatteryLevels(dDomeBattery, dDomeCutOff, dShutterBattery, dShutterCutOff);
                if(dShutterCutOff < 1.0f) // not right.. ask again
                    m_RTIDome.getBatteryLevels(dDomeBattery, dDomeCutOff, dShutterBattery, dShutterCutOff);
                sTmpBuf << std::fixed << std::setprecision(2) << dDomeBattery << " V";
                uiex->setPropertyString("domeBatteryLevel","text", sTmpBuf.str().c_str());
                std::stringstream().swap(sTmpBuf);
                if(m_bHasShutterControl) {
                    if(dShutterBattery>=0.0f)
                        sTmpBuf << std::fixed << std::setprecision(2) << dShutterBattery << " V";
                    else
                        sTmpBuf << "--";
                    uiex->setPropertyString("shutterBatteryLevel","text", sTmpBuf.str().c_str());
                }
                else {
                    uiex->setPropertyString("shutterBatteryLevel","text", "NA");
                }
                nErr = m_RTIDome.getRainSensorStatus(nRainSensorStatus);
                if(nErr)
                    uiex->setPropertyString("rainStatus","text", "--");
                else {
                    std::stringstream().swap(sTmpBuf);
                    sTmpBuf << (nRainSensorStatus==NOT_RAINING ? "<html><head/><body><p><span style=\" color:#00FF00;\">Not raining</span></p></body></html>" : "<html><head/><body><p><span style=\" color:#FF0000;\">Raining</span></p></body></html>");
                    uiex->setPropertyString("rainStatus","text", sTmpBuf.str().c_str());
                }
            }
        }
    }

    else if (!strcmp(pszEvent, "on_pushButton_clicked"))
    {
        if(m_bLinked) {
            if( m_bCalibratingDome) { // Abort
                // enable buttons
                uiex->setEnabled("pushButtonOK", true);
                uiex->setEnabled("pushButtonCancel", true);
                uiex->setEnabled("pushButton_2", true);
                // stop everything
                m_RTIDome.abortCurrentCommand();
                m_bCalibratingDome = false;
                // set button text the Calibrate
                uiex->setText("pushButton", "Calibrate");
				// restore saved ticks per rev
				uiex->setPropertyInt("ticksPerRev","value", m_nSavedTicksPerRev);
				m_RTIDome.setNbTicksPerRev(m_nSavedTicksPerRev);
            } else {								// Calibrate
                // disable buttons
                uiex->setEnabled("pushButtonOK", false);
                uiex->setEnabled("pushButtonCancel", false);
                uiex->setEnabled("pushButton_2", false);
                // change "Calibrate" to "Abort"
                uiex->setText("pushButton", "Abort");
				m_nSavedTicksPerRev = m_RTIDome.getNbTicksPerRev();
                m_RTIDome.calibrate();
                m_bCalibratingDome = true;
            }
        }
    }
    
    else if (!strcmp(pszEvent, "on_pushButton_2_clicked")) {
        // set Pan ID
        uiex->propertyInt("panID", "value", nPanId);
        nErr = m_RTIDome.setPanId(nPanId);
        if(nErr) {
            sErrorMessage << "Error setting Xbee PAN ID : Error " << nErr;
            uiex->messageBox("RTI-Dome Set PanID", sErrorMessage.str().c_str());
            return;
        }
        m_nPanId = nPanId;
        uiex->setEnabled("pushButton_2", false);
        m_bSettingPanID = true;
        m_SetPanIdTimer.Reset();
    }

    else if (!strcmp(pszEvent, "on_pushButton_3_clicked")) {
        m_RTIDome.restoreDomeMotorSettings();
        // read values from dome controller
        n_nbStepPerRev = m_RTIDome.getNbTicksPerRev();
        uiex->setPropertyInt("ticksPerRev","value", n_nbStepPerRev);

        m_RTIDome.getRotationSpeed(nSpeed);
        uiex->setPropertyInt("rotationSpeed","value", nSpeed);

        m_RTIDome.getRotationAcceleration(nAcc);
        uiex->setPropertyInt("rotationAcceletation","value", nAcc);
    }

    else if (!strcmp(pszEvent, "on_pushButton_4_clicked")) {
        m_RTIDome.restoreShutterMotorSettings();
        // read values from dome controller
        m_RTIDome.getShutterSpeed(nSpeed);
        uiex->setPropertyInt("shutterSpeed","value", nSpeed);

        m_RTIDome.getShutterAcceleration(nAcc);
        uiex->setPropertyInt("shutterAcceleration","value", nAcc);
    }

    else if (!strcmp(pszEvent, "on_checkBox_stateChanged"))
    {
        m_bLogRainStatus = uiex->isChecked("checkBox");
        if(m_bLogRainStatus) {
            m_RTIDome.getRainStatusFileName(fName);
            uiex->setPropertyString("filePath","text", fName.c_str());
        }
        else {
            uiex->setPropertyString("filePath","text", "");
        }
    }

   else if (!strcmp(pszEvent, "on_pushButton_5_clicked")) {
        if(uiex->isChecked("checkBox_2")) {
            m_RTIDome.setUseDHCP(true);
        }
        else {
            m_RTIDome.setUseDHCP(false);
            uiex->propertyString("IPAddress", "text", szTmpBuf, SERIAL_BUFFER_SIZE);
            m_RTIDome.setIpAddress(std::string(szTmpBuf));

            uiex->propertyString("SubnetMask", "text", szTmpBuf, SERIAL_BUFFER_SIZE);
            m_RTIDome.setSubnetMask(std::string(szTmpBuf));

            uiex->propertyString("GatewayIP", "text", szTmpBuf, SERIAL_BUFFER_SIZE);
            m_RTIDome.setIPGateway(std::string(szTmpBuf));
        }
        m_RTIDome.reconfigureNetwork();
        m_bSettingNetwork = true;
        m_SetNetworkTimer.Reset();
    }

    else if (!strcmp(pszEvent, "on_checkBox_2_stateChanged")) {
        if(uiex->isChecked("checkBox_2")) {
            uiex->setEnabled("IPAddress", false);
            uiex->setEnabled("SubnetMask", false);
            uiex->setEnabled("GatewayIP", false);
        }
        else {
            uiex->setEnabled("IPAddress", true);
            uiex->setEnabled("SubnetMask", true);
            uiex->setEnabled("GatewayIP", true);
        }
    }
}

//
//HardwareInfoInterface
//
#pragma mark - HardwareInfoInterface

void X2Dome::deviceInfoNameShort(BasicStringInterface& str) const
{
	str = "RTI-Dome";
}

void X2Dome::deviceInfoNameLong(BasicStringInterface& str) const
{
    str = "RTI-Dome";
}

void X2Dome::deviceInfoDetailedDescription(BasicStringInterface& str) const
{
    str = "RTI-Dome Dome Controller";
}

 void X2Dome::deviceInfoFirmwareVersion(BasicStringInterface& str)
{

    if(m_bLinked) {
        std::string sFirmware;
        float fVersion;
		X2MutexLocker ml(GetMutex());
        m_RTIDome.getFirmwareVersion(sFirmware, fVersion);
        str = sFirmware.c_str();

    }
    else
        str = "N/A";
}

void X2Dome::deviceInfoModel(BasicStringInterface& str)
{
    str = "RTI-Dome Dome Controller";
}

//
//DriverInfoInterface
//
#pragma mark - DriverInfoInterface

 void	X2Dome::driverInfoDetailedInfo(BasicStringInterface& str) const
{
    str = "RTI-Dome Dome Controller X2 plugin by Rodolphe Pineau";
}

double	X2Dome::driverInfoVersion(void) const
{
	return PLUGIN_VERSION;
}

//
//DomeDriverInterface
//
#pragma mark - DomeDriverInterface

int X2Dome::dapiGetAzEl(double* pdAz, double* pdEl)
{
    if(!m_bLinked)
        return ERR_NOLINK;

	X2MutexLocker ml(GetMutex());

    *pdAz = m_RTIDome.getCurrentAz();
    *pdEl = m_RTIDome.getCurrentEl();
    return SB_OK;
}

int X2Dome::dapiGotoAzEl(double dAz, double dEl)
{
    int nErr;

    if(!m_bLinked)
        return ERR_NOLINK;

	X2MutexLocker ml(GetMutex());

    nErr = m_RTIDome.gotoAzimuth(dAz);
    if(nErr)
        return MAKE_ERR_CODE(PLUGIN_ID, DriverRootInterface::DT_DOME, nErr);

    else
        return SB_OK;
}

int X2Dome::dapiAbort(void)
{
    if(!m_bLinked)
        return ERR_NOLINK;

	X2MutexLocker ml(GetMutex());

    m_RTIDome.abortCurrentCommand();

    return SB_OK;
}

int X2Dome::dapiOpen(void)
{
    int nErr;

    if(!m_bLinked)
        return ERR_NOLINK;

    X2MutexLocker ml(GetMutex());

    m_RTIDome.getShutterPresent(m_bHasShutterControl);
    
	if(!m_bHasShutterControl)
        return SB_OK;


    nErr = m_RTIDome.openShutter();
    if(nErr)
        return MAKE_ERR_CODE(PLUGIN_ID, DriverRootInterface::DT_DOME, nErr);

	return SB_OK;
}

int X2Dome::dapiClose(void)
{
    int nErr;

    if(!m_bLinked)
        return ERR_NOLINK;

    X2MutexLocker ml(GetMutex());

    m_RTIDome.getShutterPresent(m_bHasShutterControl);

    if(!m_bHasShutterControl)
        return SB_OK;


    nErr = m_RTIDome.closeShutter();
    if(nErr)
        return MAKE_ERR_CODE(PLUGIN_ID, DriverRootInterface::DT_DOME, nErr);

	return SB_OK;
}

int X2Dome::dapiPark(void)
{
    int nErr;

    if(!m_bLinked)
        return ERR_NOLINK;

	X2MutexLocker ml(GetMutex());

    nErr = m_RTIDome.parkDome();
    if(nErr)
        return MAKE_ERR_CODE(PLUGIN_ID, DriverRootInterface::DT_DOME, nErr);

	return SB_OK;
}

int X2Dome::dapiUnpark(void)
{
    int nErr;

    if(!m_bLinked)
        return ERR_NOLINK;

	X2MutexLocker ml(GetMutex());

    nErr = m_RTIDome.unparkDome();
    if(nErr)
        return MAKE_ERR_CODE(PLUGIN_ID, DriverRootInterface::DT_DOME, nErr);

	return SB_OK;
}

int X2Dome::dapiFindHome(void)
{
    int nErr;

    if(!m_bLinked)
        return ERR_NOLINK;

	X2MutexLocker ml(GetMutex());

	nErr = m_RTIDome.goHome();
    if(nErr)
        return MAKE_ERR_CODE(PLUGIN_ID, DriverRootInterface::DT_DOME, nErr);

    return SB_OK;
}

int X2Dome::dapiIsGotoComplete(bool* pbComplete)
{
    int nErr;

    if(!m_bLinked)
        return ERR_NOLINK;

	X2MutexLocker ml(GetMutex());

	nErr = m_RTIDome.isGoToComplete(*pbComplete);
    if(nErr)
        return MAKE_ERR_CODE(PLUGIN_ID, DriverRootInterface::DT_DOME, nErr);
    return SB_OK;
}

int X2Dome::dapiIsOpenComplete(bool* pbComplete)
{
    int nErr;

    if(!m_bLinked)
        return ERR_NOLINK;

    if(!m_bHasShutterControl)
    {
        *pbComplete = true;
        return SB_OK;
    }

	X2MutexLocker ml(GetMutex());

	nErr = m_RTIDome.isOpenComplete(*pbComplete);
    if(nErr)
        return MAKE_ERR_CODE(PLUGIN_ID, DriverRootInterface::DT_DOME, nErr);

    return SB_OK;
}

int	X2Dome::dapiIsCloseComplete(bool* pbComplete)
{
    int nErr;

    if(!m_bLinked)
        return ERR_NOLINK;

    if(!m_bHasShutterControl)
    {
        *pbComplete = false;    // it can't be open and closed at the same time :)
        return SB_OK;
    }

	X2MutexLocker ml(GetMutex());

	nErr = m_RTIDome.isCloseComplete(*pbComplete);
    if(nErr)
        return MAKE_ERR_CODE(PLUGIN_ID, DriverRootInterface::DT_DOME, nErr);

    return SB_OK;
}

int X2Dome::dapiIsParkComplete(bool* pbComplete)
{
    int nErr;

    if(!m_bLinked)
        return ERR_NOLINK;

	X2MutexLocker ml(GetMutex());

	nErr = m_RTIDome.isParkComplete(*pbComplete);
    if(nErr)
        return MAKE_ERR_CODE(PLUGIN_ID, DriverRootInterface::DT_DOME, nErr);

    return SB_OK;
}

int X2Dome::dapiIsUnparkComplete(bool* pbComplete)
{
    int nErr;

    if(!m_bLinked)
        return ERR_NOLINK;

	X2MutexLocker ml(GetMutex());

	nErr = m_RTIDome.isUnparkComplete(*pbComplete);
    if(nErr)
        return MAKE_ERR_CODE(PLUGIN_ID, DriverRootInterface::DT_DOME, nErr);

    return SB_OK;
}

int X2Dome::dapiIsFindHomeComplete(bool* pbComplete)
{
    int nErr;

    if(!m_bLinked)
        return ERR_NOLINK;

	X2MutexLocker ml(GetMutex());

	nErr = m_RTIDome.isFindHomeComplete(*pbComplete);
    if(nErr)
        return MAKE_ERR_CODE(PLUGIN_ID, DriverRootInterface::DT_DOME, nErr);

    return SB_OK;
}

int X2Dome::dapiSync(double dAz, double dEl)
{
    int nErr;

    if(!m_bLinked)
        return ERR_NOLINK;

	X2MutexLocker ml(GetMutex());

	nErr = m_RTIDome.syncDome(dAz, dEl);
    if(nErr)
        return MAKE_ERR_CODE(PLUGIN_ID, DriverRootInterface::DT_DOME, nErr);
	return SB_OK;
}

//
// SerialPortParams2Interface
//
#pragma mark - SerialPortParams2Interface

void X2Dome::portName(BasicStringInterface& str) const
{
    char szPortName[SERIAL_BUFFER_SIZE];

    portNameOnToCharPtr(szPortName, SERIAL_BUFFER_SIZE);

    str = szPortName;

}

void X2Dome::setPortName(const char* szPort)
{
    if (m_pIniUtil)
        m_pIniUtil->writeString(PARENT_KEY, CHILD_KEY_PORTNAME, szPort);
}


void X2Dome::portNameOnToCharPtr(char* pszPort, const int& nMaxSize) const
{
    if (NULL == pszPort)
        return;

    snprintf(pszPort, nMaxSize, DEF_PORT_NAME);

    if (m_pIniUtil)
        m_pIniUtil->readString(PARENT_KEY, CHILD_KEY_PORTNAME, pszPort, pszPort, nMaxSize);

}
