rpineau/RTI-Dome/x2dome.h

#include <stdio.h>
#include <string.h>

#include "../../licensedinterfaces/domedriverinterface.h"
#include "../../licensedinterfaces/serialportparams2interface.h"
#include "../../licensedinterfaces/modalsettingsdialoginterface.h"
#include "../../licensedinterfaces/x2guiinterface.h"
#include "../../licensedinterfaces/sberrorx.h"
#include "../../licensedinterfaces/basicstringinterface.h"
#include "../../licensedinterfaces/serxinterface.h"
#include "../../licensedinterfaces/basiciniutilinterface.h"
#include "../../licensedinterfaces/theskyxfacadefordriversinterface.h"
#include "../../licensedinterfaces/sleeperinterface.h"
#include "../../licensedinterfaces/loggerinterface.h"
#include "../../licensedinterfaces/basiciniutilinterface.h"
#include "../../licensedinterfaces/mutexinterface.h"
#include "../../licensedinterfaces/tickcountinterface.h"
#include "../../licensedinterfaces/serialportparams2interface.h"

#include "RTI-Dome.h"
#include "StopWatch.h"

#define PARENT_KEY			        "RTI-Dome"
#define CHILD_KEY_PORTNAME	        "PortName"
#define CHILD_KEY_HOME_ON_PARK      "HomeOnPark"
#define CHILD_KEY_HOME_ON_UNPARK    "HomeOnUnpark"
#define CHILD_KEY_LOG_RAIN_STATUS   "LogRainStatus"

#if defined(SB_WIN_BUILD)
#define DEF_PORT_NAME				"COM1"
#elif defined(SB_MAC_BUILD)
#define DEF_PORT_NAME				"/dev/cu.Bluetooth-Incoming-Port"
#elif defined(SB_LINUX_BUILD)
#define DEF_PORT_NAME				"/dev/ttyUSB0"
#endif

#define LOG_BUFFER_SIZE 256
/*!
\brief The X2Dome example.

\ingroup Example

Use this example to write an X2Dome driver.
*/
class X2Dome: public DomeDriverInterface, public SerialPortParams2Interface, public ModalSettingsDialogInterface, public X2GUIEventInterface
{
public:

	/*!Standard X2 constructor*/
	X2Dome(	const char* pszSelectionString,
					const int& nISIndex,
					SerXInterface*						pSerX,
					TheSkyXFacadeForDriversInterface* pTheSkyX,
					SleeperInterface*				pSleeper,
					BasicIniUtilInterface*			pIniUtil,
					LoggerInterface*					pLogger,
					MutexInterface*					pIOMutex,
					TickCountInterface*				pTickCount);
	virtual ~X2Dome();

	/*!\name DriverRootInterface Implementation
	See DriverRootInterface.*/
	//@{
	virtual DeviceType							deviceType(void) {return DriverRootInterface::DT_DOME;}
	virtual int									queryAbstraction(const char* pszName, void** ppVal);
	//@}

	/*!\name LinkInterface Implementation
	See LinkInterface.*/
	//@{
	virtual int									establishLink(void)						;
	virtual int									terminateLink(void)						;
	virtual bool								isLinked(void) const					;
	//@}

    virtual int initModalSettingsDialog(void){return 0;}
    virtual int execModalSettingsDialog(void);

	/*!\name HardwareInfoInterface Implementation
	See HardwareInfoInterface.*/
	//@{
	virtual void deviceInfoNameShort(BasicStringInterface& str) const					;
	virtual void deviceInfoNameLong(BasicStringInterface& str) const					;
	virtual void deviceInfoDetailedDescription(BasicStringInterface& str) const		;
	virtual void deviceInfoFirmwareVersion(BasicStringInterface& str)					;
	virtual void deviceInfoModel(BasicStringInterface& str)							;
	//@}

	/*!\name DriverInfoInterface Implementation
	See DriverInfoInterface.*/
	//@{
	virtual void								driverInfoDetailedInfo(BasicStringInterface& str) const	;
	virtual double								driverInfoVersion(void) const								;
	//@}

	//DomeDriverInterface
	virtual int dapiGetAzEl(double* pdAz, double* pdEl);
	virtual int dapiGotoAzEl(double dAz, double dEl);
	virtual int dapiAbort(void);
	virtual int dapiOpen(void);
	virtual int dapiClose(void);
	virtual int dapiPark(void);
	virtual int dapiUnpark(void);
	virtual int dapiFindHome(void);
	virtual int dapiIsGotoComplete(bool* pbComplete);
	virtual int dapiIsOpenComplete(bool* pbComplete);
	virtual int	dapiIsCloseComplete(bool* pbComplete);
	virtual int dapiIsParkComplete(bool* pbComplete);
	virtual int dapiIsUnparkComplete(bool* pbComplete);
	virtual int dapiIsFindHomeComplete(bool* pbComplete);
	virtual int dapiSync(double dAz, double dEl);

    //SerialPortParams2Interface
    virtual void			portName(BasicStringInterface& str) const;
    virtual void			setPortName(const char* szPort);
    virtual unsigned int	baudRate() const			{return 9600;};
    virtual void			setBaudRate(unsigned int)	{};
    virtual bool			isBaudRateFixed() const		{return true;};

    virtual SerXInterface::Parity	parity() const				{return SerXInterface::B_NOPARITY;};
    virtual void					setParity(const SerXInterface::Parity& parity){};
    virtual bool					isParityFixed() const		{return true;};



    virtual void uiEvent(X2GUIExchangeInterface* uiex, const char* pszEvent);

private:

	SerXInterface 									*	GetSerX() {return m_pSerX; }
	TheSkyXFacadeForDriversInterface				*	GetTheSkyXFacadeForDrivers() {return m_pTheSkyX;}
	SleeperInterface								*	GetSleeper() {return m_pSleeper; }
	BasicIniUtilInterface							*	GetSimpleIniUtil() {return m_pIniUtil; }
	LoggerInterface									*	GetLogger() {return m_pLogger; }
	MutexInterface									*	GetMutex()  {return m_pIOMutex;}
	TickCountInterface								*	GetTickCountInterface() {return m_pTickCount;}

	SerXInterface									*	m_pSerX;
	TheSkyXFacadeForDriversInterface				*	m_pTheSkyX;
	SleeperInterface								*	m_pSleeper;
	BasicIniUtilInterface							*	m_pIniUtil;
	LoggerInterface									*	m_pLogger;
	MutexInterface									*	m_pIOMutex;
	TickCountInterface								*	m_pTickCount;

    void portNameOnToCharPtr(char* pszPort, const int& nMaxSize) const;


	int         m_nPrivateISIndex;
	bool        m_bLinked;
    CRTIDome    m_RTIDome;
    bool        m_bHasShutterControl;
    bool        m_bHomeOnPark;
    bool        m_bHomeOnUnpark;
    bool        m_bOpenUpperShutterOnly;
    bool        m_bCalibratingDome;
	int			m_nSavedTicksPerRev;
    int         m_nPanId;
    bool        m_bSettingPanID;
    bool        m_bLogRainStatus;

    CStopWatch  m_SetPanIdTimer;

    bool        m_bSettingNetwork;
    CStopWatch  m_SetNetworkTimer;

    // bool        mIsRollOffRoof;
};
