rpineau/RTI-Dome/Hardware/Firmwares/RotatorEth/RemoteShutterClass.h

//
// RTI-Zone Dome Rotator firmware. Based on https://github.com/nexdome/Automation/tree/master/Firmwares
// As I contributed to the "old" 2,x firmware and was somewhat familiar with it I decided to reuse it and
// fix most of the known issues. I also added some feature related to XBee init and reset.
// This is meant to run on an Arduino DUE as we put the AccelStepper run() call in an interrupt
//

class RemoteShutterClass
{
public:
	// Todo: remove this if state becomes a string
	enum ShutterStates { OPEN, CLOSED, OPENING, CLOSING, ERROR };

	// TODO: See if these can all be strings
	// These have to be real data for communications reasos
	String state = "4"; // Cause we don't know until the shutter tells us.

	// These aren't used by Rotator so why bother converting them to numeric values?
	String	acceleration = "";
	String	elevation = "";
	String	OpenError = "";
	String	speed = "";
	String	reversed = "";
	String	stepsPerStroke = "";
	// ASCOM checks version and if it's blank then shutter doesn't exist
	String	version = "";
	String	volts = "";
	String	watchdogInterval = "90"; // set proper default.. just in case.
	String  panid = "0000";
	String  lowVoltStateOrRaining = "";
	RemoteShutterClass();
};

RemoteShutterClass::RemoteShutterClass()
{

}
