rpineau/RTI-Dome/Hardware/Firmwares/RotatorEth/EtherMac.h

//
// Create MAC address from DUE unique ID
//

#ifndef __ETHER_MAC__
#define __ETHER_MAC__

#define EEFC_FKEY 0x5A
//#define EEFC_FMR_SCOD   (0x1ul << 16)
//#define IFLASH0_ADDR  0x00080000                               // Flash memory begins at 0x00080000
//#define IFLASH1_ADDR ( IFLASH0_ADDR + IFLASH_SIZE / 2 )        // IFLASH1_ADDR         = 0x000C0000

__attribute__ ((section (".ramfunc")))
void ReadUniqueID( uint32_t * latch_buffer )
{
    char __FWS;
                                                                  // Set bit 16 of EEFC_FMR : See chap. 49.1.1.2 page 1442
    EFC0->EEFC_FMR |= EEFC_FMR_SCOD;                              // Sequential code optimization disable
  __FWS = (EFC0->EEFC_FMR & EEFC_FMR_FWS_Msk)>>EEFC_FMR_FWS_Pos ; // Save FWS value
    EFC0->EEFC_FMR &=~ EEFC_FMR_FWS_Msk;
    EFC0->EEFC_FMR |= EEFC_FMR_FWS(6);                            // 6+1 wait states for read and write operations

    EFC0->EEFC_FMR &=~EEFC_FMR_FAM;                               // 128-bit access in read Mode only, to enhance access speed.
    while(!(EFC0->EEFC_FSR & EEFC_FSR_FRDY));                     // Send the  STUI command if FRDY bit is high to begin reading in flash

    EFC0->EEFC_FCR = EEFC_FCR_FKEY(EEFC_FKEY) | EFC_FCMD_STUI ;
    while(EFC0->EEFC_FSR & EEFC_FSR_FRDY);                        //Wait till FRDY falls down
                                                                  // The Unique Identifier is located in the first 128 bits of
                                                                  // the Flash bank 0 in between 0x080000 and 0x08000C (and of the Flash bank 1 in between 0X0C0000 and 0x0C000C ??)
    memcpy(latch_buffer, (void*)IFLASH0_ADDR, 16);                // Read first 128 bits ( 16 first bytes) in one shot beginning at address IFLASHIndex_ADDR
                                                                  // Send the SPUI command to stop reading in flash
    EFC0->EEFC_FCR = EEFC_FCR_FKEY(EEFC_FKEY) | EFC_FCMD_SPUI ;
    while(!(EFC0->EEFC_FSR & EEFC_FSR_FRDY));                     // Wait till FRDY rises up

                                                                  // Clear bit 16 of EEFC_FMR : See chap. 49.1.1.2 page 1442
    EFC0->EEFC_FMR &= ~EEFC_FMR_SCOD;                             // Sequential code optimization enable
    EFC0->EEFC_FMR &=~ EEFC_FMR_FWS_Msk;                          // Restore FWS value
    EFC0->EEFC_FMR |= EEFC_FMR_FWS(__FWS);
}


void getMacAddress(byte* macBuffer, uint32_t* uid)
{
    ReadUniqueID(uid);
    macBuffer[0] = 0x52;
    macBuffer[1] = 0x54;
    macBuffer[2] = 0x49;
    macBuffer[3] = (byte)((uid[3]>>16) & 0x000000ff);
    macBuffer[4] = (byte)((uid[3]>>8)  & 0x000000ff);
    macBuffer[5] = (byte)((uid[3])     & 0x000000ff);
}

#endif // __ETHER_MAC__
