rpineau/RTI-Dome/(commit log)

2020-10-06 Initial import for the RTI-Dome hardware and X2 plugin
    [RTI-Dome.brd, RTI-Dome.sch]
2020-10-07 Added code to reset motor settings to defaults
    [RTI-Dome.cpp, RTI-Dome.h, Shutter.ino]
2020-10-07 Reset watchdog time if button are used... as this means the user is physicaly present in the dome.
    [Shutter.ino, ShutterClass.h]
2020-10-09 Fix standalone mode in plugin and firmware.
    [RTI-Dome.cpp, RTI-Dome.h, RotatorClass.h, x2dome.cpp]
2020-10-09 PCB for wire connection instead of STL direct.
    [RTI-Dome-wire.brd, RTI-Dome-wire.sch]
2020-10-09 Fix small error on schematics
    [RTI-Dome-wire.sch, RTI-Dome.sch]
2020-10-12 Fix some components positions
    [RTI-Dome-wire.brd, RTI-Dome.brd]
2020-10-12 Code cleanup. Added option for different stepper controller in the Firmwares (need testing for the ISD0x).
2020-10-12 OSX needs DTR for AVR Arduino, not for the due.
2020-10-12 Fix some timing issue when restoring default values on an AVR
    [RTI-Dome.cpp]
2020-10-13 Fix run in Rotator.Run() for AVR
    [RotatorClass.h]
2020-10-13 Shutter watchdog value bug fix.
    [Shutter.ino, ShutterClass.h]
2020-10-13 Fix a small stepper.run call to smooth the rotation on AVR
2020-10-14 Improve Arduio Due timer interrupt for AccelStepper
2020-10-15 Fix some issue with the interrupt . now it stops smoothly :)
    [RTI-Dome.cpp, RTI-Dome.h, RotatorClass.h, Shutter.ino, ShutterClass.h, x2dome.cpp, x2dome.h]
2020-10-15 Stop interrupt in motor disable code.
    [RTI-Dome-wire.brd, RTI-Dome-wire.sch, RTI-Dome.brd, RTI-Dome.sch]
2020-10-16 Started adding some extra connection.. for dual shutter systems.
    [RTI-Dome-wire.brd, RTI-Dome.brd]
2020-10-16 Rename directory
    [RTI-Dome-wire.brd, RTI-Dome-wire.sch, RTI-Dome.brd, RTI-Dome.sch]
2020-10-17 Auto detect shutter presence.
    [RTI-Dome-wire.brd, RTI-Dome-wire.sch, RTI-Dome.brd, RTI-Dome.sch]
2020-10-17 Remove debug printf
2020-10-17 Fix default values for shutter motor. This will probably change after real world testing.
    [ShutterClass.h]
2020-10-21 Adding a little bit of code to add in interrupt when passing the home sensor.
2020-10-21 Putting home pin in n interrupt
2020-10-21 Disable home interrupt for now as AccelStepper SyncPosition stops the motor, preventing a proper resync of the position.
    [RotatorClass.h]
2020-10-23 Forgot to reset the timer to write the rain status.
    [RTI-Dome.cpp]
2020-10-23 Wrong control check in the UI
    [x2dome.cpp]
2020-10-24 Remove the code that keeps changing the home azimuth .. chassing both edges of the magnet is not usefull :)
2020-10-24 Change the calibration. Doesn't need to start from home. Ig the dome is at home, it backs a bit so it can pass the sensor twice to get a proper delta over one rotation.
    [RotatorClass.h]
2020-10-24 Use the new calibration in the plugin as we don't need to home before.
2020-10-24 Fix calibration and home speed to 2500 steps/s
    [RotatorClass.h]
2020-10-25 Adding a small board to connect multiple sensors (RG-11, AAG cloudwatcher, ..) to the RG-11 input of the main board
    [sensors.brd, sensors.sch]
2020-10-28 Fixing some issue with auto close on low power
    [RTI-Dome.cpp, RTI-Dome.h, RemoteShutterClass.h, Shutter.ino, ShutterClass.h]
2020-10-28 More fixes related to low voltage detection. The firware does close the shutter on low voltage. Sometimes the state is not known immediately to the rotator and the cached value is out of sync. This i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
    [RTI-Dome.cpp, RemoteShutterClass.h, Shutter.ino, ShutterClass.h, x2dome.cpp]
2020-10-28 Fixed more issue related to communication between the 2 modules.
    [RTI-Dome.cpp]
2020-10-29 Made a big change on the raind detection using an interrupt.. Less code, faster, more efficient, accurate.
2020-10-30 Fix missing variable init
    [RTI-Dome.cpp, RTI-Dome.h]
2020-10-31 Tested the ISD04 stepper controller.. needed to add 3.3V header as the pull-up on the buffer output don't bring the signal to 5V and therefore the optocoupler in the contoller doesn't do the right th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
    [RTI-Dome-wire.brd, RTI-Dome-wire.sch, RTI-Dome.brd, RTI-Dome.sch]
2020-10-31 Fix an issue with the button. unless there is a connection the code wasn't running. Put this in an interrupt and it works as expected now.
    [RotatorClass.h]
2020-10-31 DTR not needed on the DUE.. this will make sure people don't try to use and AVR and complain things are not working. Of course this doesn't quite solve the case of macOS that still assert DTR and res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
    [RTI-Dome.cpp]
2020-10-31 Increase calibration speed
2020-11-01 Fix some issues on the buttons action for the shuter
    [Shutter.ino, ShutterClass.h]
2020-11-01 Witht the ShutterClass object being created via 'new' as a pointer, no more crash.
    [ShutterClass.h]
2020-11-01 Fix a small issue if you try to home when at home before any move.
    [RotatorClass.h]
2020-11-01 Use Arduino DUE CDC native port to avoid reset on connect.
    [RTI-Dome.cpp, RotatorClass.h, Shutter.ino]
2020-11-02 Adding a usb-serial + usb port on SERIAL2 (pin 16 and 17)
    [RTI-Dome-wire.brd, RTI-Dome-wire.sch, RTI-Dome.brd, RTI-Dome.sch]
2020-11-02 Remove I2C 2 pin header as we now have the eeprom on the board.
    [RTI-Dome-wire.brd, RTI-Dome-wire.sch, RTI-Dome.brd, RTI-Dome.sch]
2020-11-02 Adjusting some of the default parameters for calibration/homing and acceleration
2020-11-02 Tune calibration speed.
2020-11-03 Fix a few issue about battery shutter cutoff voltage when reseting the PanID.
    [x2dome.cpp]
2020-11-05 Only focus on doing one board with terminal header. Removed the old one with STL connectors.
    [RTI-Dome-wire.brd, RTI-Dome-wire.sch, RTI-Dome.brd, RTI-Dome.sch]
2020-11-05 All pull-up for external pinsare now 4.7K
    [RTI-Dome.brd, RTI-Dome.sch]
2020-11-05 Change the polarity on the en.dir,step pin to match the ISD0x too, so no more need to have some #define in the code
    [RTI-Dome.brd, RTI-Dome.sch]
2020-11-05 Some routing optimisation. Remove 3.3V header as it's not needed anymore. Added 2 ground for good measure
    [RTI-Dome.brd, RTI-Dome.sch]
2020-11-05 fix the stepper connection to match the TB6600 and work with the ISD02/04/08 controller with the same settings
    [RTI-Dome.brd, RTI-Dome.sch]
2020-11-05 rewire the 74ABT244 to help with routing
    [RTI-Dome.brd, RTI-Dome.sch]
2020-11-05 Cleanup some signals, Added bigger polygone on both side for 12V in and motor.
    [RTI-Dome.brd]
2020-11-08 Fix an issue ins standalone mode
    [RotatorClass.h]
2020-11-08 Re-did the board with 74xx245 buffers instead of 244. Easier to route. Added a png to enable/disable the input buffer so that we can enable them after setting the interrupt and other things. It is di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
    [RTI-Dome.brd, RTI-Dome.sch]
2020-11-08 Fix comment in code
    [RTI-Dome.cpp]
2020-11-09 Fix legend on PCB.
    [RTI-Dome.brd]
2020-11-10 Added a check for the ome position on power up. If not at home , assume we're at the park postion.
2020-11-13 make the TB6600 the default for now. Once we get the new board we can remove all of this.
2020-11-18 Adding firmware that can receive commands over Ethernet using a W5500. I'll add it to the shield PCB in the next version.
2020-11-19 Adding initial proto for the controller with the W5500 ethernet chip
    [RTI-Dome-eth.brd, RTI-Dome-eth.sch]
2020-11-19 Started routing the W5500
    [RTI-Dome-eth.brd, RTI-Dome-eth.sch]
2020-11-21 Added proper ethernet chip reset.
    [RTI-Dome-eth.brd, RTI-Dome-eth.sch]
2020-11-21 Adding a simple board for the shutter as it doesn't need the extra usb port or ethernet
    [RTI-Dome-Shutter.brd, RTI-Dome-Shutter.sch]
2020-11-21 Added powerpole to shutter shield
    [RTI-Dome-Shutter.brd, RTI-Dome-Shutter.sch]
2020-11-21 Do not return an error on a homing retry
    [RTI-Dome.cpp]
2020-11-21 Better fix for the homing retry
    [RTI-Dome.cpp]
2020-11-24 update Xcode build to do x86_64 and arm64
    [RTI-Dome-eth.brd]
2020-11-25 Adding MCP120 for power on reset.
    [RTI-Dome-Shutter.brd, RTI-Dome-Shutter.sch, RTI-Dome-eth.brd, RTI-Dome-eth.sch]
2020-12-02 Redid the analog 3.3V on the ethernet shield
    [RTI-Dome-Shutter.brd, RTI-Dome-eth.brd, RTI-Dome-eth.sch]
2020-12-06 Fix issue wither ethernet server, tested extra serial port for main connection
    [RotatorClass.h, RotatorEth.ino]
2020-12-06 Fix some routing
    [RTI-Dome-Shutter.brd, RTI-Dome-eth.brd, RTI-Dome-eth.sch]
2020-12-07 Fix pin spacing issue.
    [RTI-Dome-eth.brd, RTI-Dome-eth.sch]
2020-12-07 Fix W5500 package for PCB house
    [RTI-Dome-eth.brd, RTI-Dome-eth.sch]
2020-12-08 Fix some pin routing to optimize path
    [RTI-Dome-eth.brd]
2020-12-14 Better homing code. Does necessarily stop at home bug sinf home via an interrupt. I'll add more got to go back home after passing it. It does however return the proper position after homing. Added mo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
    [RTI-Dome-Shutter.brd, RTI-Dome-eth-ENC.brd, RTI-Dome-eth-ENC.sch, RTI-Dome-eth.sch, RTI-Dome.brd]
2020-12-14 Fix calibration and homing issue. Fix buffer enable issue when reading home and rain sensor in RotatorClass constructor
    [RTI-Dome.cpp, RotatorClass.h]
2020-12-15 Fix all board for proper header alignement. New code for homing (and calibrating) tested and works.
    [RTI-Dome-Shutter.brd, RTI-Dome-eth-ENC.brd, RTI-Dome-eth.brd, RTI-Dome.brd]
2020-12-15 Fix a small bug. Added some debug.
    [RotatorClass.h]
2020-12-16 PCB optimisation
    [RTI-Dome-eth-ENC.brd, RTI-Dome-eth.brd, RTI-Dome-eth.sch, RTI-Dome.brd, RTI-Dome.sch]
2020-12-16 Fix some componenent manufacturer reference
    [RTI-Dome-Shutter.brd, RTI-Dome-Shutter.sch, RTI-Dome-eth-ENC.brd, RTI-Dome-eth-ENC.sch, RTI-Dome-eth.brd, RTI-Dome-eth.sch, RTI-Dome.brd, RTI-Dome.sch]
2020-12-16 Fix DRU
    [RTI-Dome-Shutter.brd, RTI-Dome-eth-ENC.brd, RTI-Dome-eth.brd, RTI-Dome.brd]
2020-12-16 Change oscilator package reference.
    [RTI-Dome-eth-ENC.brd, RTI-Dome-eth-ENC.sch]
2020-12-18 Adjust solder mask to minimum tolerance from PCB house
    [RTI-Dome-eth.brd]
2020-12-23 Fox termonal on eth board.
    [RTI-Dome-eth.brd]
2020-12-23 Adding 12V switching converter if using 24V for motors
    [12V_switching.brd, 12V_switching.sch]
2020-12-23 Fix switching regulator reference
    [12V_switching.brd, 12V_switching.sch]
2020-12-25 Fix ethernet LED.
    [RTI-Dome-eth.brd, RTI-Dome-eth.sch]
2020-12-25 Differential pair are now closer to be the same length.
    [RTI-Dome-eth.brd]
2020-12-25 Trace optimisation around the FTDI chip
    [12V_switching.brd, 12V_switching.sch, RTI-Dome-eth.brd, RTI-Dome-eth.sch]
2020-12-27 Fix dimention layer on RTI-Dome-eth.brd, added MPN on all component for mouser.
    [12V_switching.brd, 12V_switching.sch, RTI-Dome-eth.brd, RTI-Dome-eth.sch]
2020-12-28 Fix mnissing define when not in debug mode.
    [RTI-Dome-eth.brd]
2020-12-30 Fix some labels on the PCBs
    [RTI-Dome-Shutter.brd, RTI-Dome-eth.brd]
2021-01-02 Make MAC address selectable from the settings dialog so you can cut/paste it to your router to set a static lease.
2021-01-03 Added FTDI reset as it wasn't doing a proper reset on power up. Finished IP config in the plugin.
    [RTI-Dome-Shutter.brd, RTI-Dome-Shutter.sch, RTI-Dome-eth.sch]
2021-01-04 Better reset code for external chip.
    [RotatorEth.ino, Shutter.ino]
2021-01-05 Made some changes to the shutter controller to be able to control axtra linear actuator via external relay board.
    [RTI-Dome-Shutter.brd, RTI-Dome-Shutter.sch]
2021-01-14 Cleanup unused boards and sketches
    [RTI-Dome-eth-ENC.brd, RTI-Dome-eth-ENC.sch, RTI-Dome-eth.brd, RTI-Dome-eth.sch, RTI-Dome.brd, RTI-Dome.sch]
2021-01-14 Revert "Cleanup unused boards and sketches"
    This reverts commit 55a3d73229767f07f24b7c99b357f5ead4999c3a.
    [RTI-Dome-eth-ENC.brd, RTI-Dome-eth-ENC.sch, RTI-Dome.brd, RTI-Dome.sch]
2021-01-14 Fix shutter board
    [RTI-Dome-Shutter.brd, RTI-Dome-Shutter.sch]
2021-01-14 More cleanup
    [RTI-Dome-eth-ENC.brd, RTI-Dome-eth-ENC.sch]
2021-01-15 The FTDI reset pull donw should bt 10K to make sure we can reset properly
    [RTI-Dome-eth.brd, RTI-Dome-eth.sch]
2021-01-15 Fix some board issue on the shutter
    [RTI-Dome-Shutter.brd, RTI-Dome-Shutter.sch]
2021-01-15 Approve all the "Errors" for the powerpole
    [RTI-Dome-Shutter.brd]
2021-01-26 Change pin mode for better interrupt detection
    [12V_switching.brd, 12V_switching.sch, RTI-Dome-Shutter.brd, RTI-Dome-eth.brd]
2021-01-27 Set all varialble used in interrupt to volatile
2021-03-07 All recent update to pcb and code are in.
    [RTI-Dome-Shutter.brd, RTI-Dome-Shutter.sch, RTI-Dome-eth.brd, RTI-Dome-eth.sch]
2021-03-08 Increase FTDI reset time as 500ms was not enough apparently.
    [RotatorEth.ino]
2021-03-10 Add a reconnect if the connection get closed. This is mostly for TCP connection as it can be closed by the other end. Fix the voltage scaling for arduino.
    [RTI-Dome.cpp, RotatorClass.h, ShutterClass.h, x2dome.cpp]
2021-03-14 Fix a few issues on wireless messages.
    [RemoteShutterClass.h, RotatorEth.ino]
2021-03-14 Fix small bug in set pan id on shutter
    [Shutter.ino]
2021-03-14 Fix the bug in shutter Firmware to use the eeprom
    [RotatorClass.h, RotatorEth.ino, Shutter.ino, ShutterClass.h]
2021-03-14 Suhtter sends ping on power up in case it's a system where the shutter is not always powered.
2021-03-16 Force park on low shutter voltage so it can land on the charging pad when closing
2021-03-16 Added code to prevent goto on low voltage in TSX
    [RTI-Dome.cpp, RotatorEth.ino]
2021-03-16 Adding code to account for the fact that the shutter could be only powered at park. Sak for rain status, send hello, ...
2021-03-19 Fix some debug messages
    [Shutter.ino, ShutterClass.h]
2021-03-20 Revert "Slow down TSX checks..."
    This reverts commit a7f1d025e4fd3b8f79b7ad7ff34d3957620888ef.
    [RTI-Dome.cpp, RTI-Dome.h]
2021-03-20 Slowing down TSX doesn't solve the communication error once in a while over TCP. Reverting
    [RTI-Dome.cpp, RTI-Dome.h]
2021-03-23 Re-did some of the core to receive data from network and wireless connection
    [RTI-Dome-Shutter.brd, RTI-Dome-Shutter.sch, RTI-Dome-eth.brd, RTI-Dome-eth.sch]
2021-03-27 Remove unused board.
    [RTI-Dome.brd, RTI-Dome.sch]
2021-03-27 Adding BOM for rotator shield
    [RTI-Dome-eth.csv]
2021-03-27 Adding shutter shield BOM
    [RTI-Dome-Shutter.csv]
2021-03-28 Making some pull-up pull-down to get a better OFF state when the controller is not powered but the stepper driver is.
    [RTI-Dome-Shutter.brd, RTI-Dome-Shutter.sch, RTI-Dome-eth.brd, RTI-Dome-eth.sch]
2021-03-28 Pull-down doesn't really help. Setting back to pull-up to make sure enable does enable :)
    [RTI-Dome-Shutter.brd, RTI-Dome-Shutter.sch, RTI-Dome-eth.brd, RTI-Dome-eth.sch]
2021-03-29 Remove the Reconnect code as it will not work as is and we're trying to find the issue in TSX related to TCP.
    [RTI-Dome.cpp, RTI-Dome.h]
2021-03-30 Fix a non connected network on the board... the motor VOut .. :(
    [12V_switching.brd, 12V_switching.sch]
2021-03-30 Update some of the components on the 12V adapter.
    [12V_switching.brd, 12V_switching.sch]
2021-03-30 Adding a hole to fic the board to a support.
    [12V_switching.brd]
2021-04-04 Fix a few component values.
    [RTI-Dome-Shutter.brd, RTI-Dome-Shutter.sch, RTI-Dome-eth.brd, RTI-Dome-eth.sch]
2021-04-10 Fix a potential bug on close.
    [ShutterClass.h]
2021-04-10 Fix the open/close detection. Code is a lot simpler and now works every time.
    [ShutterClass.h]
2021-05-18 Fix version in innosetup file. Added comments in firmware for number of steps per rotation for different domes.
    [RotatorClass.h]
2021-05-31 Fix a few issues on homing.
    [RotatorClass.h]
2021-06-05 Fixing a small bug on open/close initial state. Improved the opening/closing in case of spurious interrupt.
    [ShutterClass.h]
2021-06-06 Chamge the way we check bondary after a goto. Fix some firmware stuff.
    [RTI-Dome.cpp, RTI-Dome.h, RotatorClass.h]
2021-06-07 Fix a bug in the boundary check
    [RTI-Dome.cpp]
2021-06-17 Fix dome open/close issues
    [RTI-Dome.cpp, RTI-Dome.h, RotatorEth.ino, Shutter.ino, ShutterClass.h, x2dome.h]
2021-06-17 Fix the false state for m_bWasRunning
    [ShutterClass.h]
2021-08-21 Add proper xbee issue detection and try to not just reconfigurethe Xbee but reset it before.
    [RotatorEth.ino]
2021-08-22 Code cleanup in watchdog trigger and XBee resets
    [RotatorEth.ino, Shutter.ino]
2021-08-22 Reset XBee if xbee init is requested
    [RotatorEth.ino]
2021-08-28 Properly return an error if we try to open but it rains (the controller will not open anyway).
    [RTI-Dome.cpp, RTI-Dome.h]
2021-09-19 Fix a small issue with logging code not compiling on Linux
    [RTI-Dome.cpp, RTI-Dome.h]
2021-09-19 Trying to fix a bug on Linux
    [RTI-Dome.cpp]
2022-01-28 Fix InnoSetup file to detect TSX64 install path even if TSX32 was never ran.
    [RTI-Dome-eth.brd, RTI-Dome-eth.sch]
2022-02-09 Migrated to Eagle 9.6
    [RTI-Dome-Shutter.brd, RTI-Dome-Shutter.csv, RTI-Dome-Shutter.sch, RTI-Dome-eth.brd, RTI-Dome-eth.csv, RTI-Dome-eth.sch]
2022-06-05 A bit of code cleanup. Also read rain status directly in addition to the interrupt
2022-06-05 Reset interrupts every 12 hours. For some reason they stop working after a while.
    [RotatorEth.ino, Shutter.ino]
2022-06-05 Remove delauy between detaching interrup and re-attaching them.
2022-06-22 Fix some code for standalone mode.
    [RotatorEth.ino]
2022-07-01 Fix merge conflict
    [12V_switching.brd, 12V_switching.sch, RTI-Dome-Shutter.brd, RTI-Dome-Shutter.sch, RTI-Dome-eth.brd, RTI-Dome-eth.sch]
2022-07-03 Small changes for rotator board without Ethernet
